Prototype-Fund-Hardware/MYND-Hardware/README.md

# MYND loudspeaker 
This is a community repository (inofficial) for the open hardware of the Teufel loudspeaker MYND: https://teufel.de/mynd-107002004

Due to the file size, the STL files were not uploaded. They can be downloaded directly from the Teufel website: https://docs.teufel.de/download/MYND/open_source.zip

The repository for the firmware can be found here: https://github.com/teufelaudio/mynd-firmware

## License 
CC BY-SA 4.0 Copyright (c) 2025 Lautsprecher Teufel GmbH. 
The corresponding licenses can be found in the CAD and PCB folders.
