Prototype-Fund-Hardware/MYND-Hardware/PCB_Schematic/KiCad/Conn_Amp/ALTIUM_EMBEDDED_MODELS/tsb0-0128d-00xxa_asm__sw0001.stp

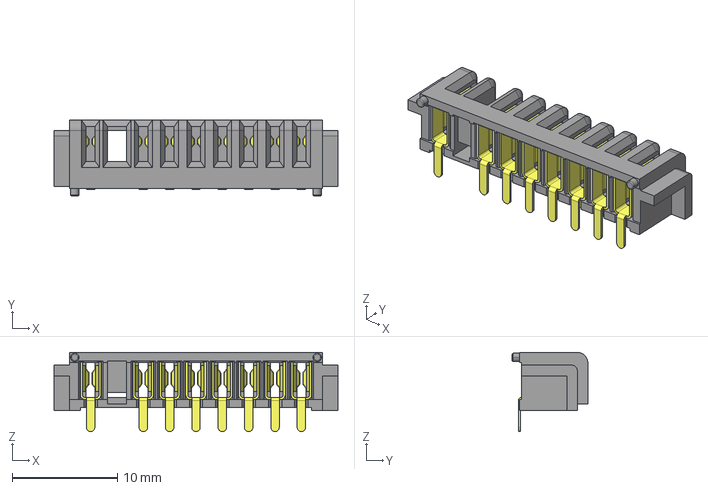
[picture p1: CAD file, 2025-05-21]
PCB_Schematic/KiCad/Conn_Amp/ALTIUM_EMBEDDED_MODELS/tsb0-0128d-00xxa_asm__sw0001.stp
26.9 x 7.18 x 7.52 mm
