Prototype-Fund-Hardware/MYND-Hardware/PCB_Schematic/KiCad/Jack_Line_In/ALTIUM_EMBEDDED_MODELS/phb-row-st-smt-2-3p_asm.stp

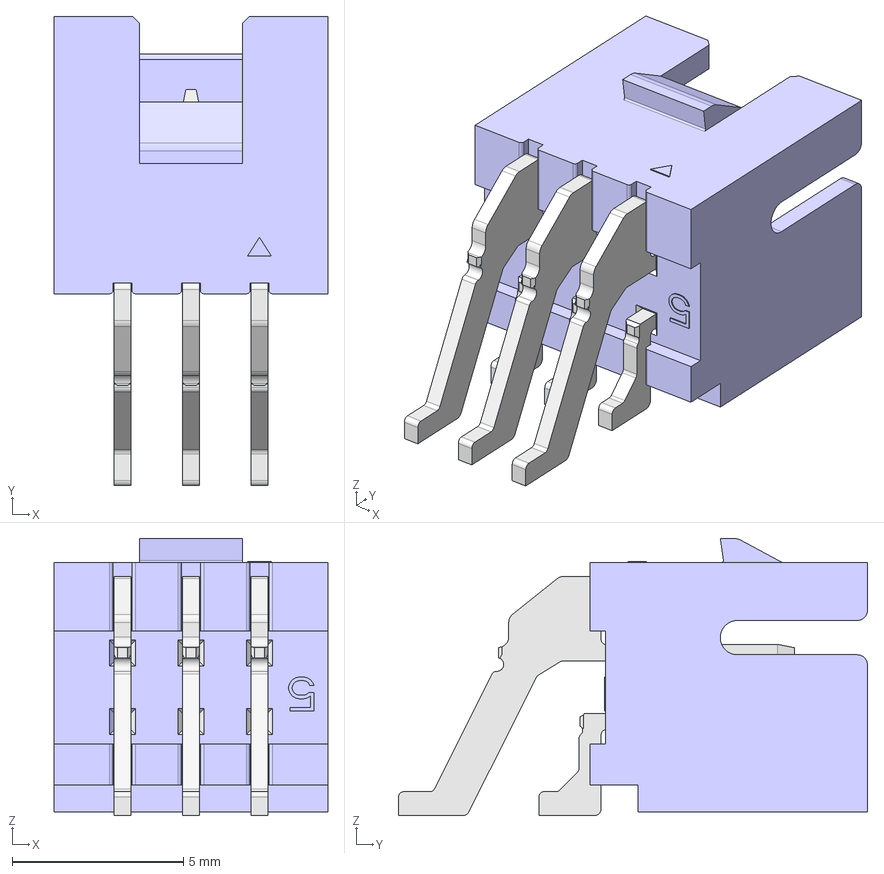
[picture p2: CAD file, 2025-05-21]
PCB_Schematic/KiCad/Jack_Line_In/ALTIUM_EMBEDDED_MODELS/phb-row-st-smt-2-3p_asm.stp
8.00 x 13.7 x 8.10 mm
