Prototype-Fund-Hardware/MYND-Hardware/PCB_Schematic/KiCad/Jack_USB/ALTIUM_EMBEDDED_MODELS/PHB-ROW-ST-SMT-2-5P_ASM.step

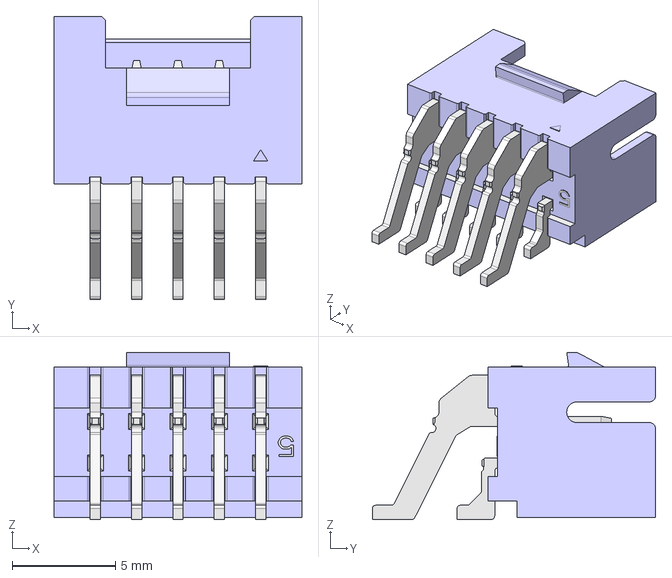
[picture p3: CAD file, 2025-05-21]
PCB_Schematic/KiCad/Jack_USB/ALTIUM_EMBEDDED_MODELS/PHB-ROW-ST-SMT-2-5P_ASM.step
12.0 x 13.7 x 8.10 mm
