Prototype-Fund-Hardware/MYND-Hardware/CAD/STP/MYND Print parts Rubber inserts.stp

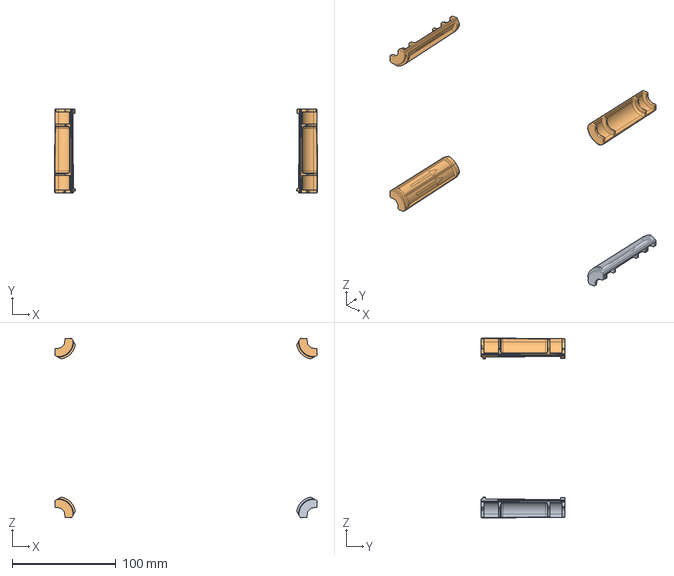
[picture p4: CAD file, 2025-05-21]
CAD/STP/MYND Print parts Rubber inserts.stp
253.1 x 81.0 x 173.1 mm
