Prototype-Fund-Hardware/MYND-Hardware/PCB_Schematic/Altium/Main/ALTIUM_EMBEDDED_MODELS/pin_header_a-sl254-eg-g03mr1.stp

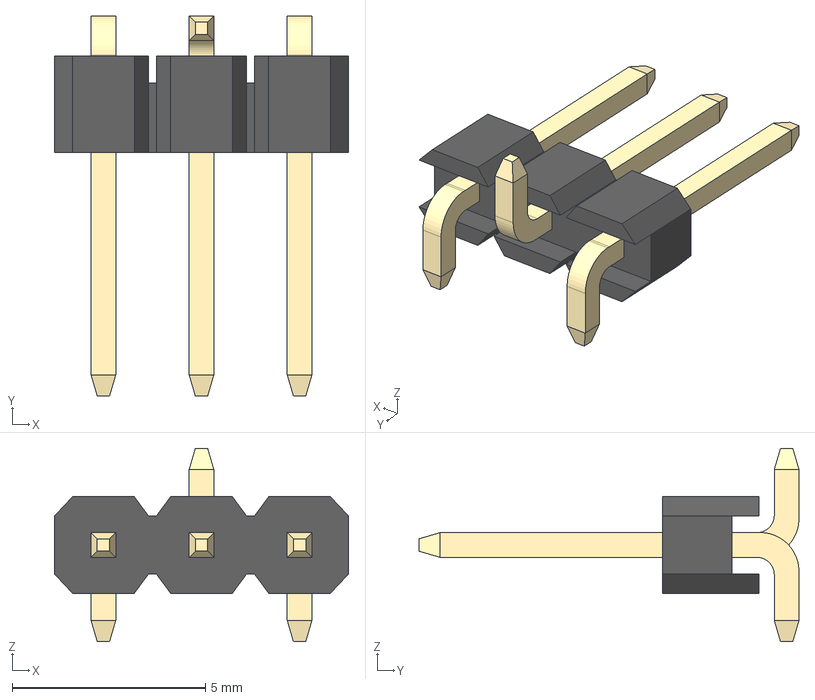
[picture p5: CAD file, 2025-05-21]
PCB_Schematic/Altium/Main/ALTIUM_EMBEDDED_MODELS/pin_header_a-sl254-eg-g03mr1.stp
7.62 x 9.84 x 5.00 mm
