Prototype-Fund-Hardware/MYND-Hardware/PCB_Schematic/KiCad/Amp/ALTIUM_EMBEDDED_MODELS/10x10_Chip.stp

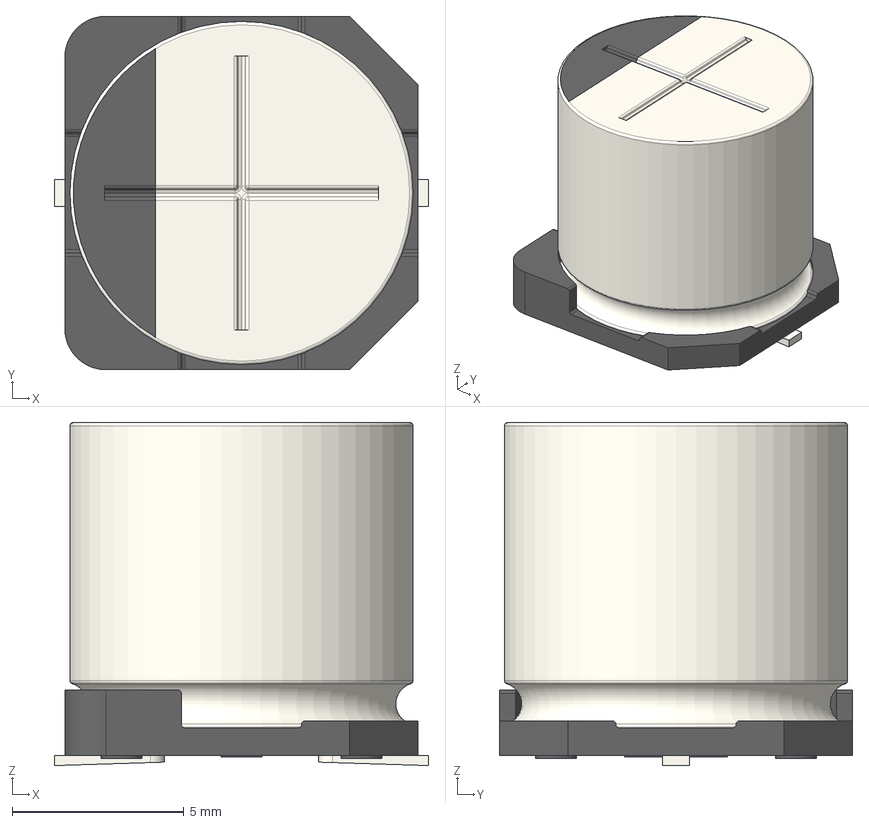
[picture p6: CAD file, 2025-05-21]
PCB_Schematic/KiCad/Amp/ALTIUM_EMBEDDED_MODELS/10x10_Chip.stp
10.9 x 10.3 x 10.0 mm
