Prototype-Fund-Hardware/MYND-Hardware/PCB_Schematic/KiCad/Bluetooth/ALTIUM_EMBEDDED_MODELS/User Library-SOT-23-2.STEP

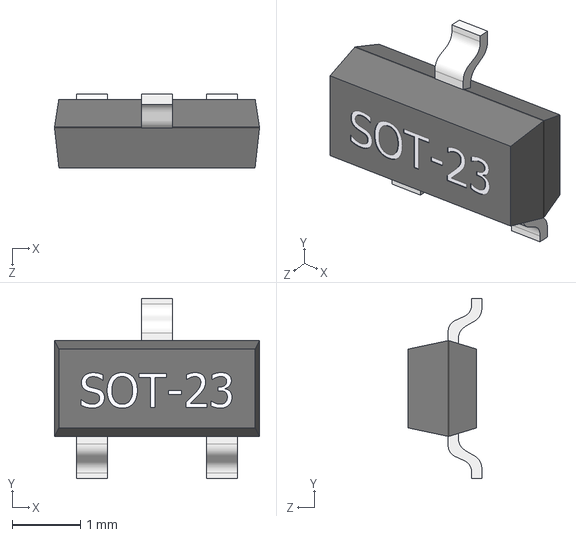
[picture p7: CAD file, 2025-05-21]
PCB_Schematic/KiCad/Bluetooth/ALTIUM_EMBEDDED_MODELS/User Library-SOT-23-2.STEP
3.00 x 2.64 x 1.08 mm
