Prototype-Fund-Hardware/MYND-Hardware/PCB_Schematic/KiCad/Conn_Baffle/ALTIUM_EMBEDDED_MODELS/A2501_6P.step

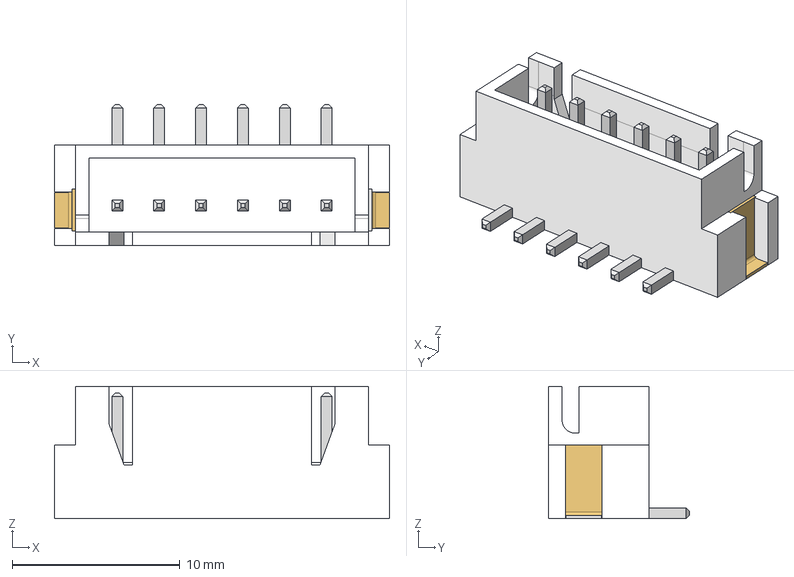
[picture p8: CAD file, 2025-05-21]
PCB_Schematic/KiCad/Conn_Baffle/ALTIUM_EMBEDDED_MODELS/A2501_6P.step
20.0 x 8.40 x 7.90 mm
Pin004
Pin005
Pin006
Pin007
Pin008
Pin009
FPin001
FPin002
FPin002_(Mirror_#1)
