Prototype-Fund-Hardware/MYND-Hardware/PCB_Schematic/KiCad/Conn_Bat/ALTIUM_EMBEDDED_MODELS/A2501W_8P.step

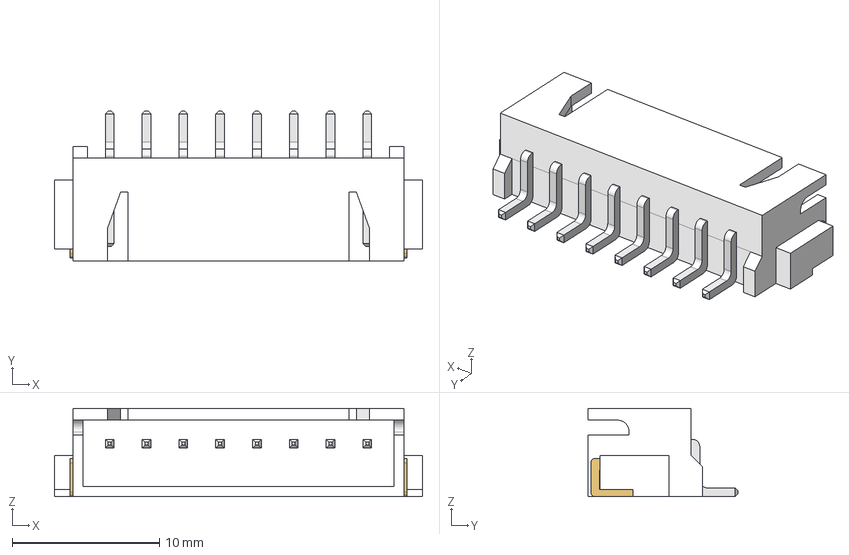
[picture p9: CAD file, 2025-05-21]
PCB_Schematic/KiCad/Conn_Bat/ALTIUM_EMBEDDED_MODELS/A2501W_8P.step
25.0 x 10.2 x 6.00 mm
FPin001
FPin002
FPin002_(Mirror_#1)
PIN001
PIN002
PIN003
PIN004
PIN005
PIN006
PIN007
PIN008
