Prototype-Fund-Hardware/MYND-Hardware/PCB_Schematic/KiCad/Jack_USB/ALTIUM_EMBEDDED_MODELS/User Library-RESC1005X___.step

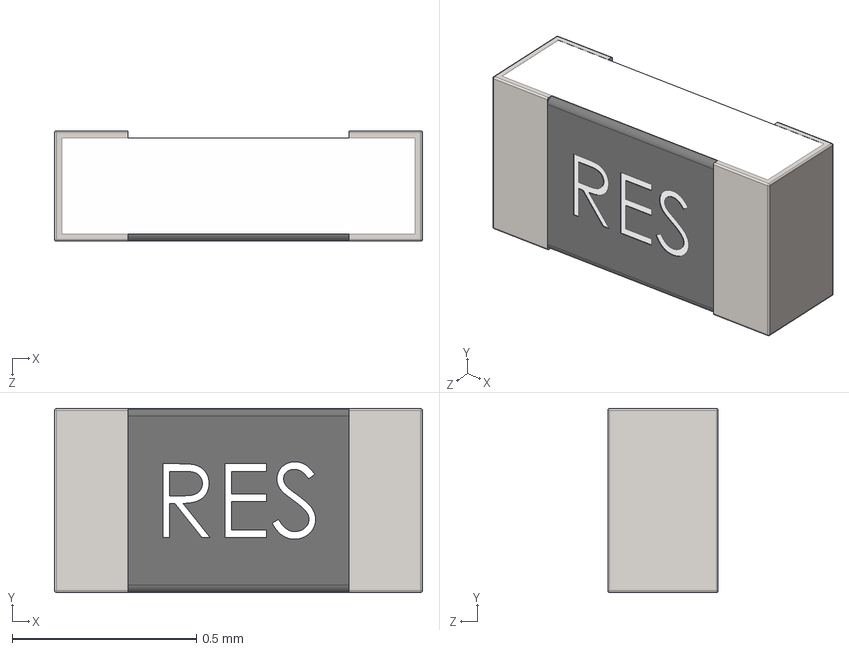
[picture p10: CAD file, 2025-05-21]
PCB_Schematic/KiCad/Jack_USB/ALTIUM_EMBEDDED_MODELS/User Library-RESC1005X___.step
1.00 x 0.5 x 0.3 mm
