Prototype-Fund-Hardware/MYND-Hardware/PCB_Schematic/KiCad/Main/ALTIUM_EMBEDDED_MODELS/0603_105.step

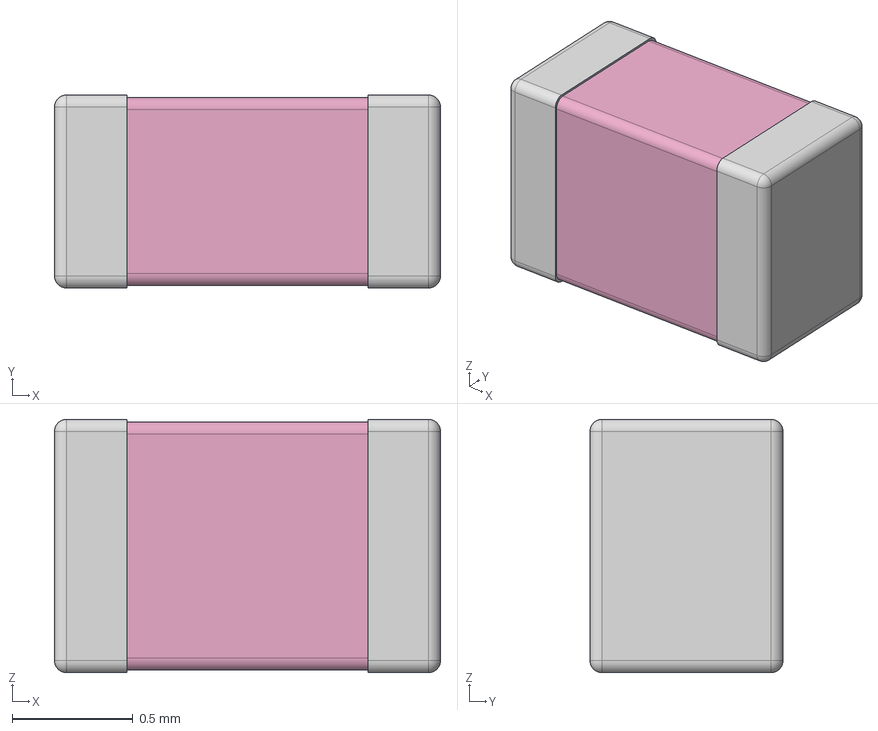
[picture p11: CAD file, 2025-05-21]
PCB_Schematic/KiCad/Main/ALTIUM_EMBEDDED_MODELS/0603_105.step
1.60 x 0.8 x 1.05 mm
