Prototype-Fund-Hardware/MYND-Hardware/PCB_Schematic/KiCad/UI/ALTIUM_EMBEDDED_MODELS/User Library-CAPC3216X___.step

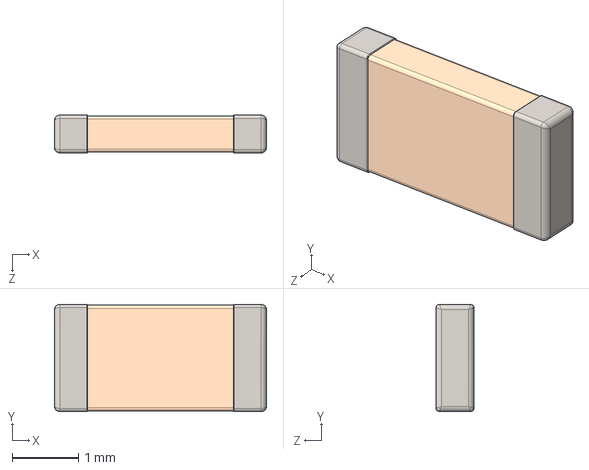
[picture p12: CAD file, 2025-05-21]
PCB_Schematic/KiCad/UI/ALTIUM_EMBEDDED_MODELS/User Library-CAPC3216X___.step
3.20 x 1.62 x 0.57 mm
