Prototype-Fund-Hardware/MYND-Hardware/CAD/STP/MYND Print parts Port housing.stp

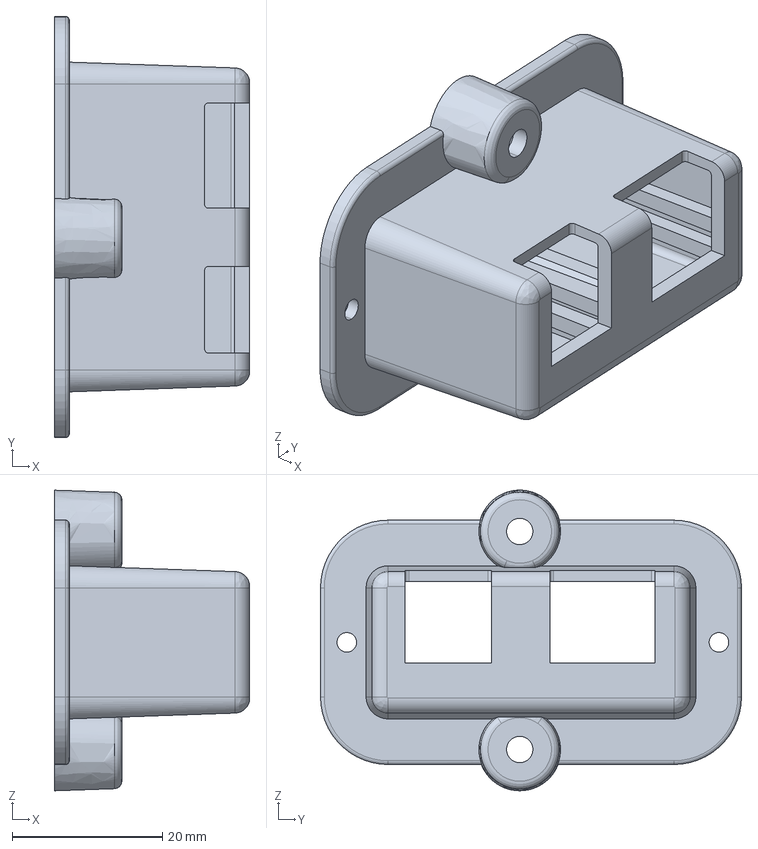
[picture p13: CAD file, 2025-05-21]
CAD/STP/MYND Print parts Port housing.stp
26.0 x 56.0 x 40.0 mm
