Prototype-Fund-Hardware/MYND-Hardware/PCB_Schematic/KiCad/Amp/ALTIUM_EMBEDDED_MODELS/0805_125.step

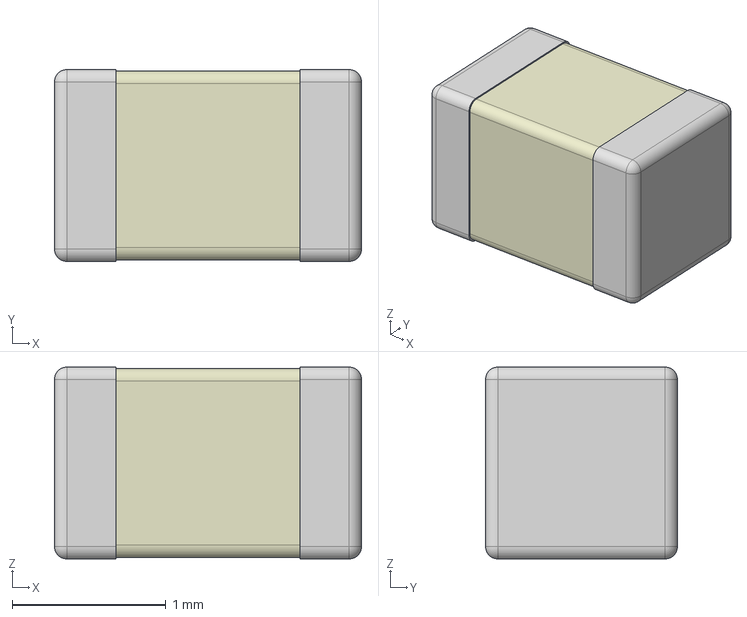
[picture p14: CAD file, 2025-05-21]
PCB_Schematic/KiCad/Amp/ALTIUM_EMBEDDED_MODELS/0805_125.step
2.00 x 1.25 x 1.25 mm
