Prototype-Fund-Hardware/MYND-Hardware/PCB_Schematic/KiCad/Bluetooth/ALTIUM_EMBEDDED_MODELS/D0008A.stp

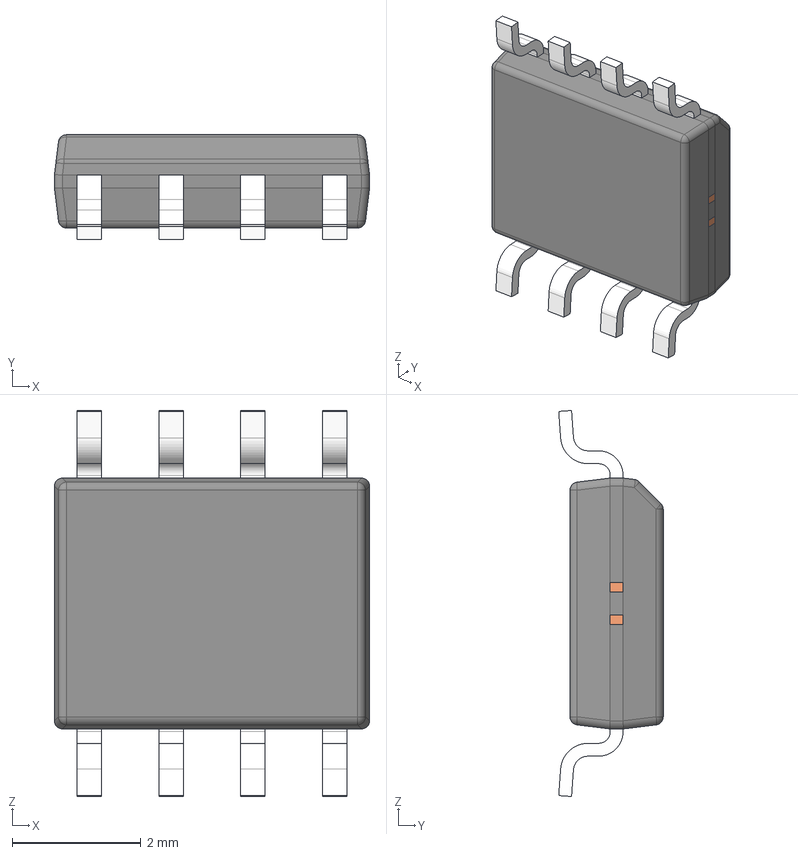
[picture p15: CAD file, 2025-05-21]
PCB_Schematic/KiCad/Bluetooth/ALTIUM_EMBEDDED_MODELS/D0008A.stp
4.90 x 1.62 x 6.00 mm
BODY_M08A_35
LEAD_M08A_57 x 8
MANIFOLD_SOLID_BREP_2784
MANIFOLD_SOLID_BREP_2935
MANIFOLD_SOLID_BREP_3086
MANIFOLD_SOLID_BREP_3237
