Prototype-Fund-Hardware/MYND-Hardware/PCB_Schematic/KiCad/Conn_Amp/ALTIUM_EMBEDDED_MODELS/pin_header_a-sl254-da-g10mp1.stp

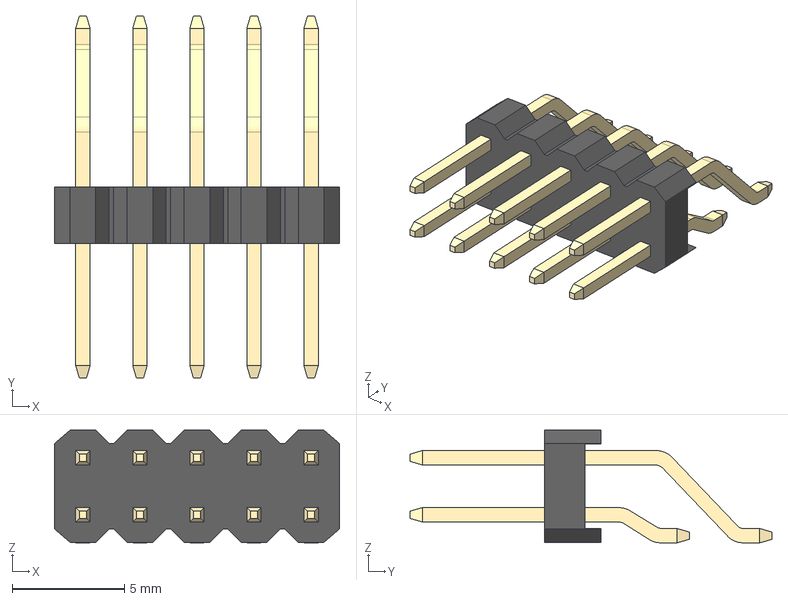
[picture p16: CAD file, 2025-05-21]
PCB_Schematic/KiCad/Conn_Amp/ALTIUM_EMBEDDED_MODELS/pin_header_a-sl254-da-g10mp1.stp
12.7 x 16.1 x 5.02 mm
