Prototype-Fund-Hardware/MYND-Hardware/PCB_Schematic/KiCad/Jack_USB/ALTIUM_EMBEDDED_MODELS/0603_50.step

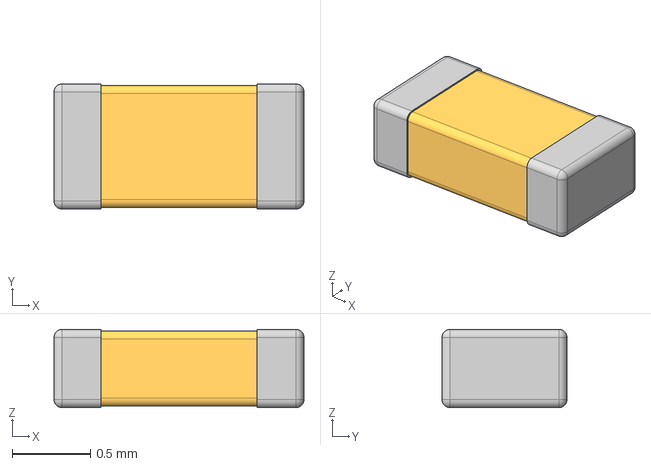
[picture p17: CAD file, 2025-05-21]
PCB_Schematic/KiCad/Jack_USB/ALTIUM_EMBEDDED_MODELS/0603_50.step
1.60 x 0.8 x 0.5 mm
