Prototype-Fund-Hardware/MYND-Hardware/PCB_Schematic/KiCad/Main/ALTIUM_EMBEDDED_MODELS/0603_80.step

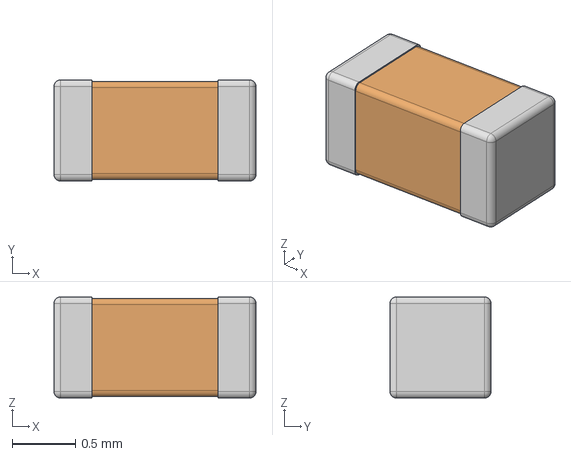
[picture p18: CAD file, 2025-05-21]
PCB_Schematic/KiCad/Main/ALTIUM_EMBEDDED_MODELS/0603_80.step
1.60 x 0.8 x 0.8 mm
