Prototype-Fund-Hardware/MYND-Hardware/CAD/STP/MYND Print parts Rubber sealing.stp

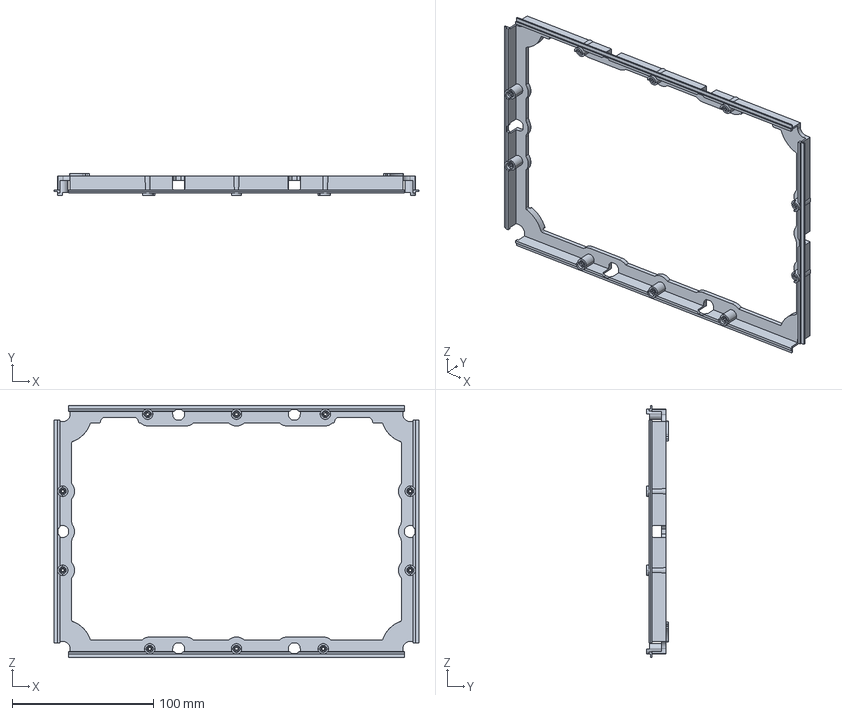
[picture p19: CAD file, 2025-05-21]
CAD/STP/MYND Print parts Rubber sealing.stp
258.8 x 15.4 x 178.8 mm
