Prototype-Fund-Hardware/MYND-Hardware/PCB_Schematic/Altium/Main/ALTIUM_EMBEDDED_MODELS/pin_header_a-sl127-dg-g10mp1.stp

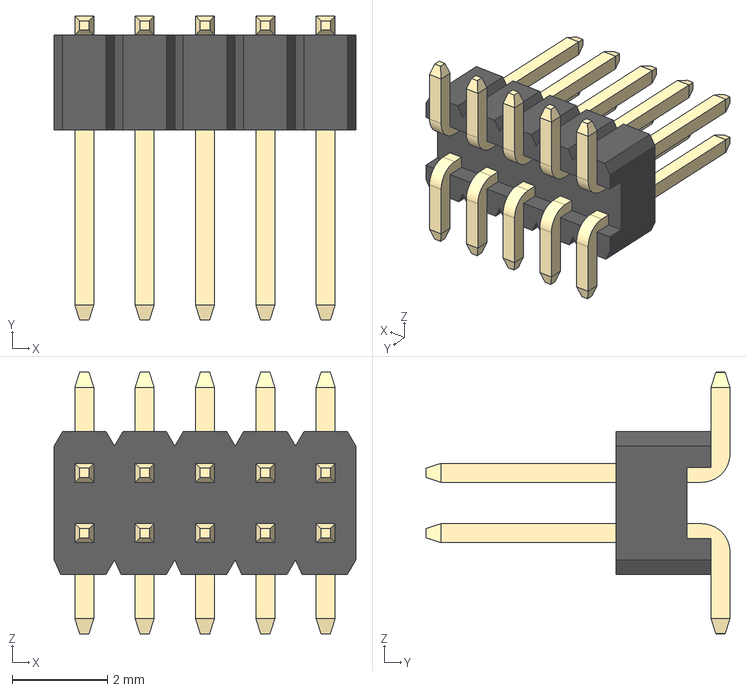
[picture p20: CAD file, 2025-05-21]
PCB_Schematic/Altium/Main/ALTIUM_EMBEDDED_MODELS/pin_header_a-sl127-dg-g10mp1.stp
6.35 x 6.40 x 5.50 mm
