Prototype-Fund-Hardware/MYND-Hardware/PCB_Schematic/KiCad/Amp/ALTIUM_EMBEDDED_MODELS/8x10_Chip.stp

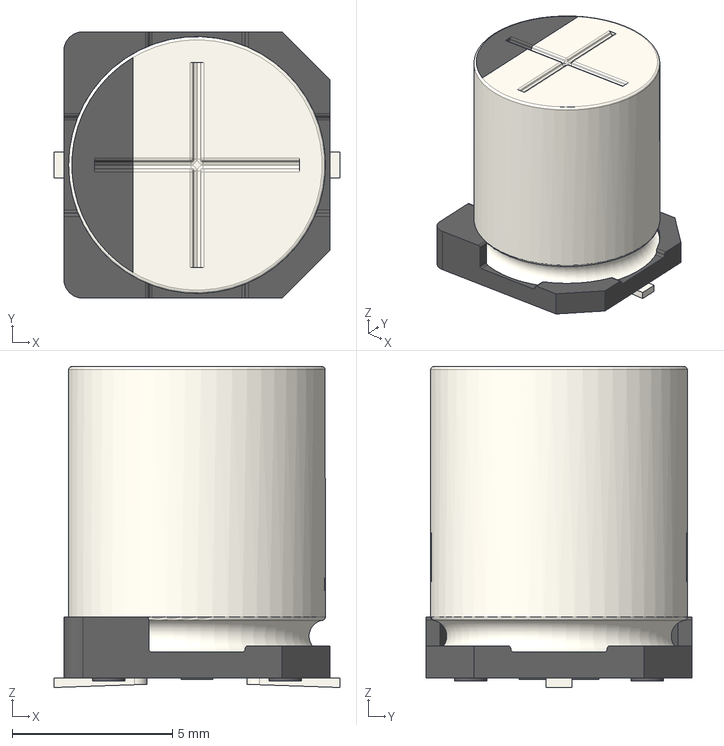
[picture p21: CAD file, 2025-05-21]
PCB_Schematic/KiCad/Amp/ALTIUM_EMBEDDED_MODELS/8x10_Chip.stp
8.90 x 8.30 x 10.0 mm
