Prototype-Fund-Hardware/MYND-Hardware/PCB_Schematic/KiCad/Bluetooth/ALTIUM_EMBEDDED_MODELS/0805_145.step

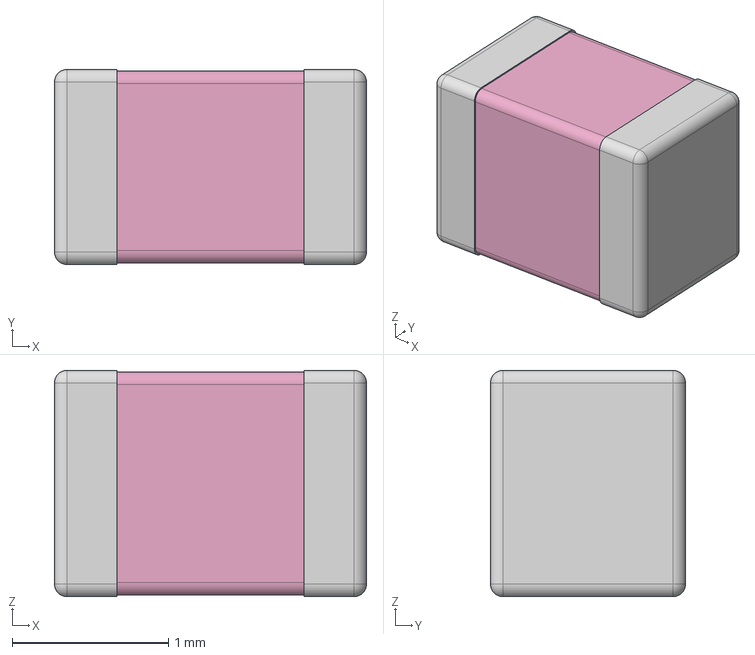
[picture p22: CAD file, 2025-05-21]
PCB_Schematic/KiCad/Bluetooth/ALTIUM_EMBEDDED_MODELS/0805_145.step
2.00 x 1.25 x 1.45 mm
