Prototype-Fund-Hardware/MYND-Hardware/PCB_Schematic/KiCad/Jack_Line_In/ALTIUM_EMBEDDED_MODELS/User Library-INDC1608X___.step

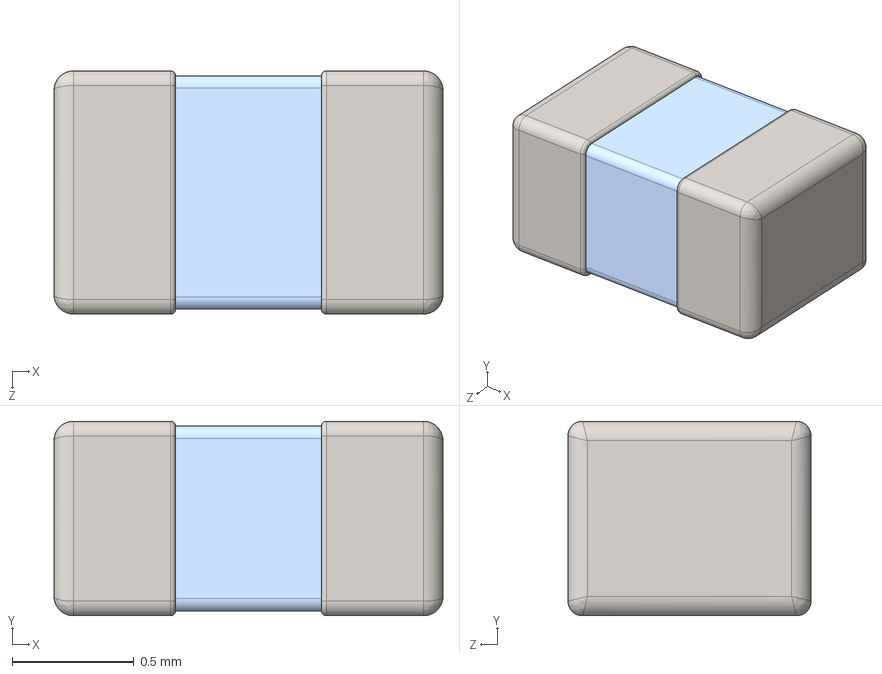
[picture p23: CAD file, 2025-05-21]
PCB_Schematic/KiCad/Jack_Line_In/ALTIUM_EMBEDDED_MODELS/User Library-INDC1608X___.step
1.60 x 0.8 x 1.00 mm
