Prototype-Fund-Hardware/MYND-Hardware/CAD/STP/MYND Print parts PR Frame.stp

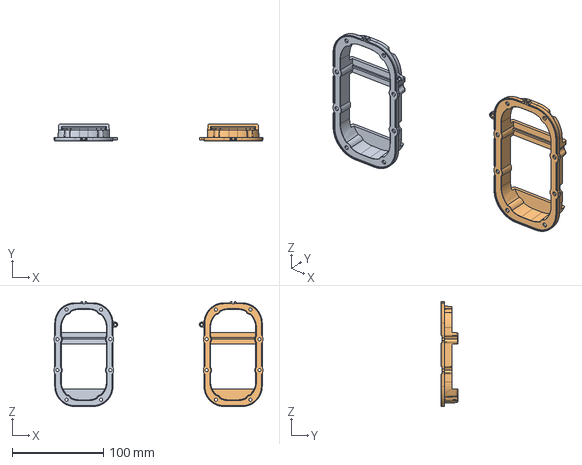
[picture p24: CAD file, 2025-05-21]
CAD/STP/MYND Print parts PR Frame.stp
229.6 x 19.0 x 115.5 mm
