Prototype-Fund-Hardware/MYND-Hardware/PCB_Schematic/KiCad/Amp/ALTIUM_EMBEDDED_MODELS/JSHC0650.step

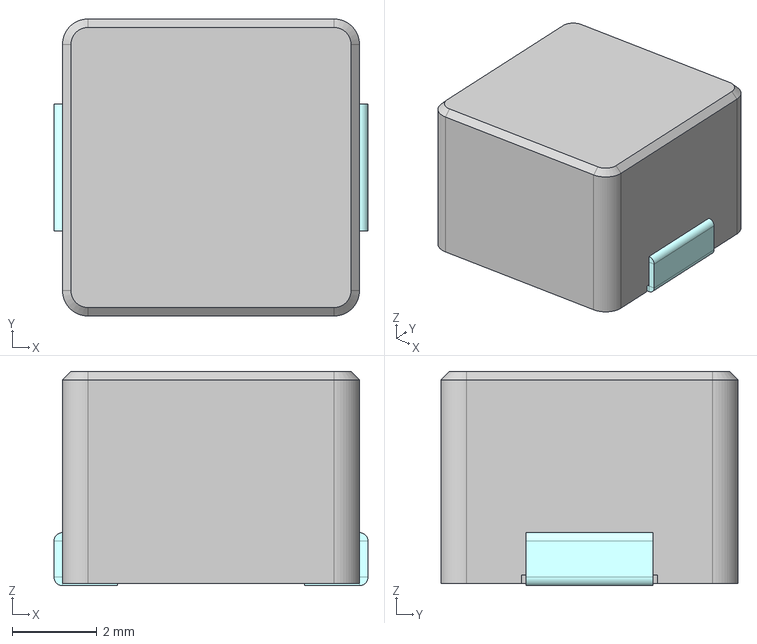
[picture p25: CAD file, 2025-05-21]
PCB_Schematic/KiCad/Amp/ALTIUM_EMBEDDED_MODELS/JSHC0650.step
7.40 x 7.00 x 5.05 mm
PIN
