Prototype-Fund-Hardware/MYND-Hardware/PCB_Schematic/KiCad/Bluetooth/ALTIUM_EMBEDDED_MODELS/User Library-IPEX.STEP

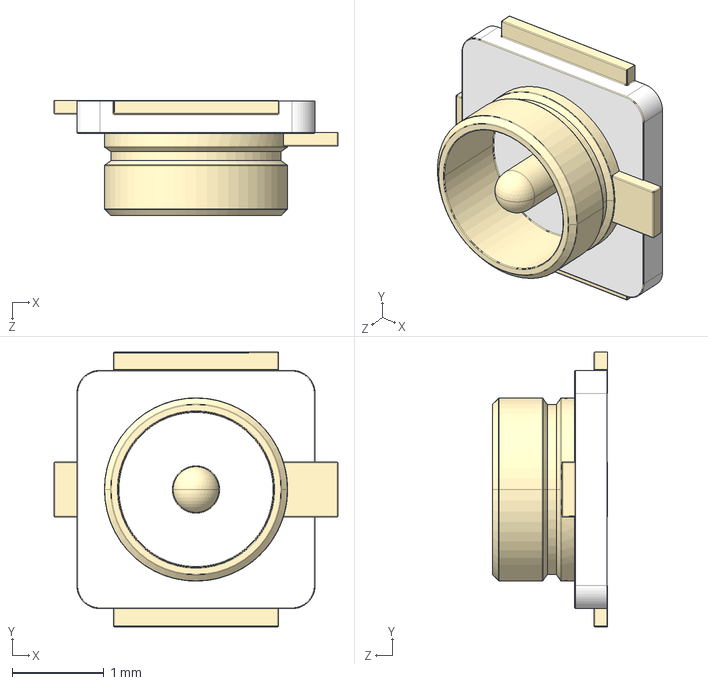
[picture p26: CAD file, 2025-05-21]
PCB_Schematic/KiCad/Bluetooth/ALTIUM_EMBEDDED_MODELS/User Library-IPEX.STEP
3.10 x 3.00 x 1.26 mm
