Prototype-Fund-Hardware/MYND-Hardware/PCB_Schematic/KiCad/Jack_USB/ALTIUM_EMBEDDED_MODELS/DFN70P101X50-2N.step

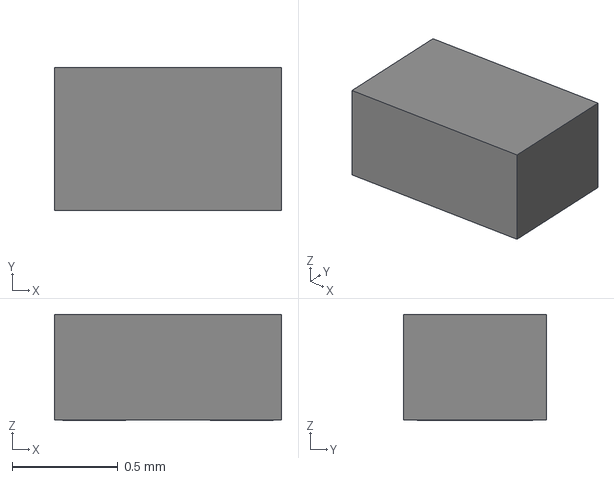
[picture p27: CAD file, 2025-05-21]
PCB_Schematic/KiCad/Jack_USB/ALTIUM_EMBEDDED_MODELS/DFN70P101X50-2N.step
1.07 x 0.675 x 0.503 mm
bigPin x 2
