Prototype-Fund-Hardware/MYND-Hardware/PCB_Schematic/KiCad/Main/ALTIUM_EMBEDDED_MODELS/TMPA1206.step

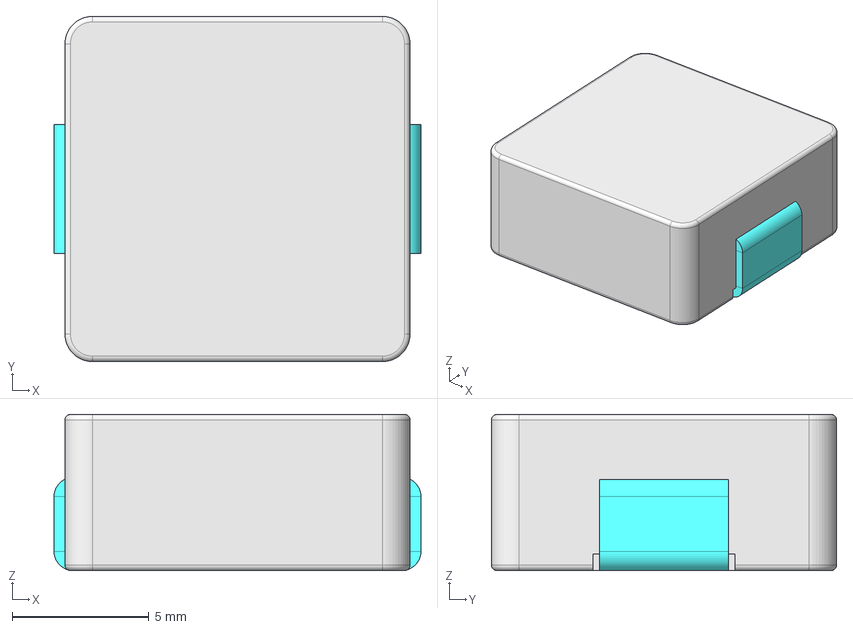
[picture p28: CAD file, 2025-05-21]
PCB_Schematic/KiCad/Main/ALTIUM_EMBEDDED_MODELS/TMPA1206.step
13.4 x 12.6 x 5.70 mm
Pin
