Prototype-Fund-Hardware/MYND-Hardware/CAD/STP/MYND Print parts Rubber feet.stp

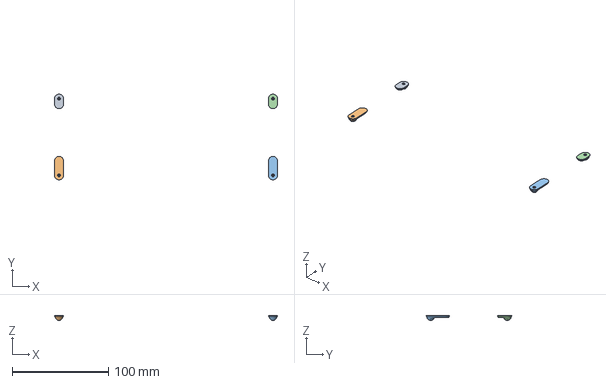
[picture p29: CAD file, 2025-05-21]
CAD/STP/MYND Print parts Rubber feet.stp
232.1 x 89.2 x 5.49 mm
