Prototype-Fund-Hardware/MYND-Hardware/PCB_Schematic/KiCad/Bluetooth/ALTIUM_EMBEDDED_MODELS/ICMF062P.step

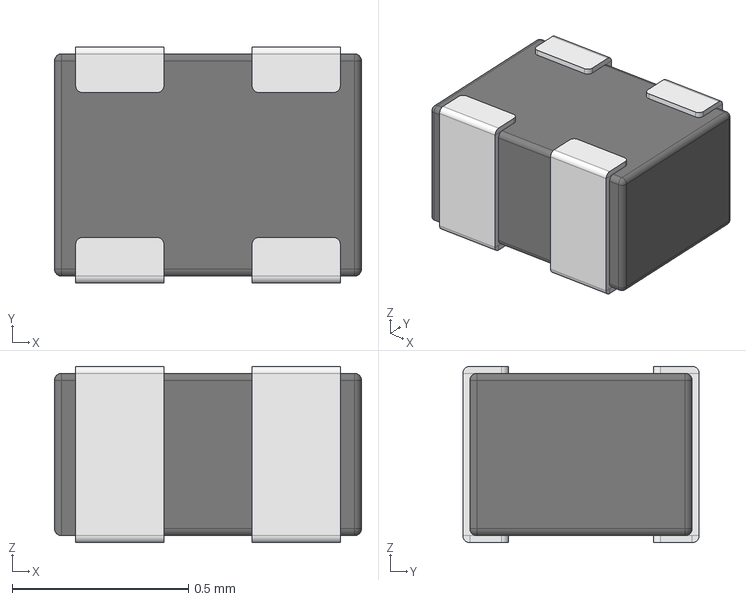
[picture p30: CAD file, 2025-05-21]
PCB_Schematic/KiCad/Bluetooth/ALTIUM_EMBEDDED_MODELS/ICMF062P.step
0.87 x 0.67 x 0.5 mm
