Prototype-Fund-Hardware/MYND-Hardware/PCB_Schematic/KiCad/Jack_Line_In/ALTIUM_EMBEDDED_MODELS/User Library-RESC1608X___.STEP

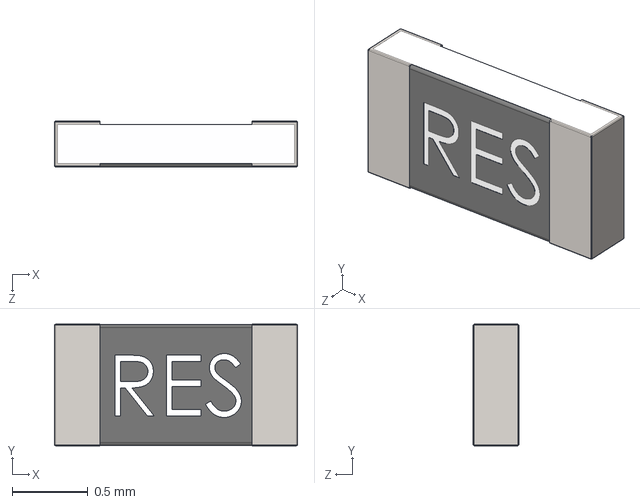
[picture p31: CAD file, 2025-05-21]
PCB_Schematic/KiCad/Jack_Line_In/ALTIUM_EMBEDDED_MODELS/User Library-RESC1608X___.STEP
1.60 x 0.8 x 0.3 mm
