Prototype-Fund-Hardware/MYND-Hardware/PCB_Schematic/KiCad/Jack_USB/ALTIUM_EMBEDDED_MODELS/User Library-SOD-123FL CASE 498.STEP

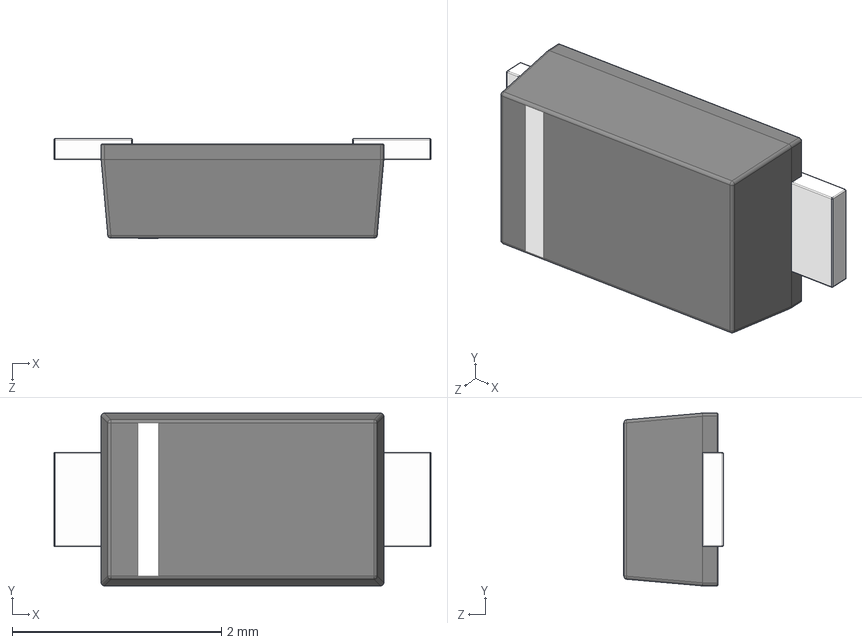
[picture p32: CAD file, 2025-05-21]
PCB_Schematic/KiCad/Jack_USB/ALTIUM_EMBEDDED_MODELS/User Library-SOD-123FL CASE 498.STEP
3.60 x 1.65 x 0.951 mm
