Prototype-Fund-Hardware/MYND-Hardware/CAD/STP/MYND Print parts Rubber HMI pad.stp

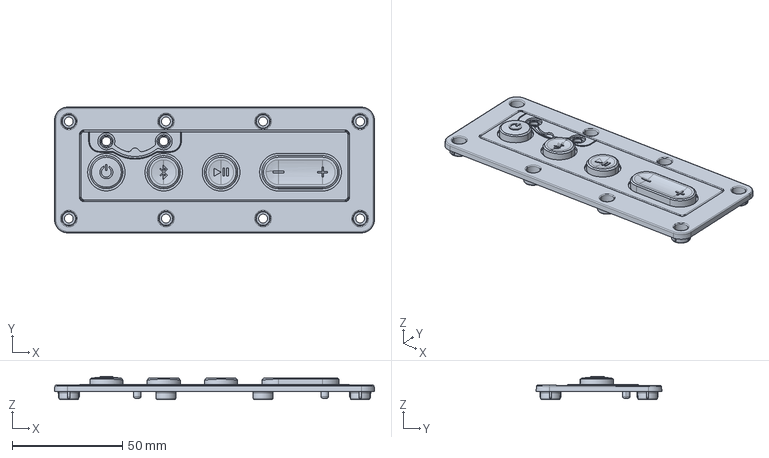
[picture p34: CAD file, 2025-05-21]
CAD/STP/MYND Print parts Rubber HMI pad.stp
145.0 x 57.0 x 10.5 mm
