Prototype-Fund-Hardware/MYND-Hardware/CAD/STP/MYND Print parts HMI cover.stp

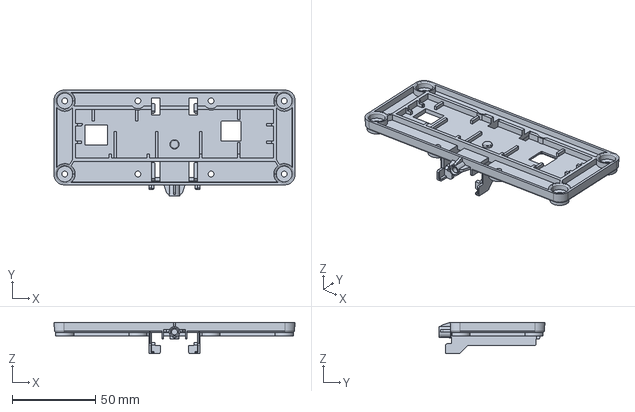
[picture p35: CAD file, 2025-05-21]
CAD/STP/MYND Print parts HMI cover.stp
145.0 x 63.7 x 18.9 mm
