Prototype-Fund-Hardware/MYND-Hardware/PCB_Schematic/KiCad/Jack_USB/ALTIUM_EMBEDDED_MODELS/K3D-DX07WH24JA3-V2_JAE_Proprietary.STEP

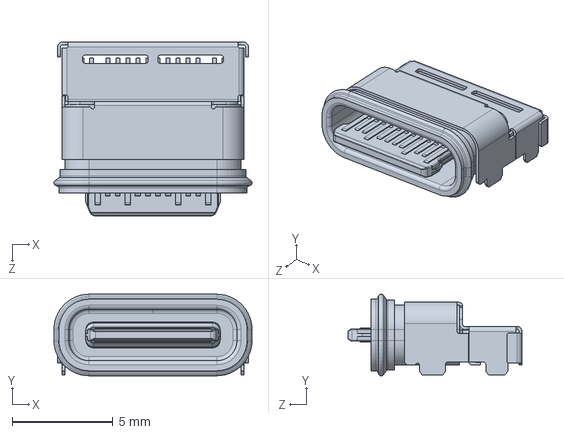
[picture p37: CAD file, 2025-05-21]
PCB_Schematic/KiCad/Jack_USB/ALTIUM_EMBEDDED_MODELS/K3D-DX07WH24JA3-V2_JAE_Proprietary.STEP
9.85 x 4.06 x 8.65 mm
