Prototype-Fund-Hardware/MYND-Hardware/PCB_Schematic/KiCad/Main/ALTIUM_EMBEDDED_MODELS/DBV0003A.stp

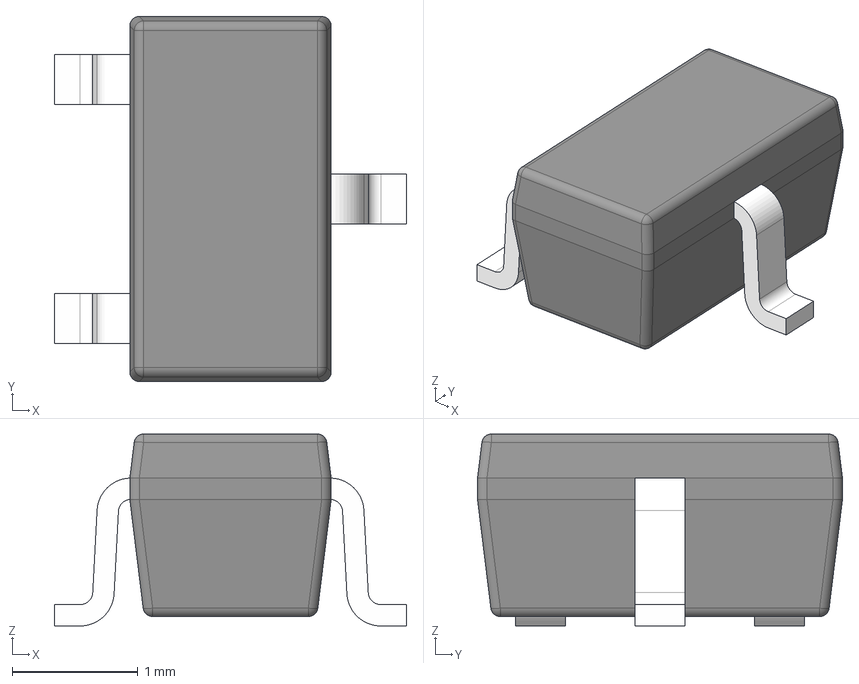
[picture p38: CAD file, 2025-05-21]
PCB_Schematic/KiCad/Main/ALTIUM_EMBEDDED_MODELS/DBV0003A.stp
2.80 x 2.90 x 1.52 mm
LEAD x 3
