Prototype-Fund-Hardware/MYND-Hardware/PCB_Schematic/Altium/Main/ALTIUM_EMBEDDED_MODELS/User Library-SOT457.STEP

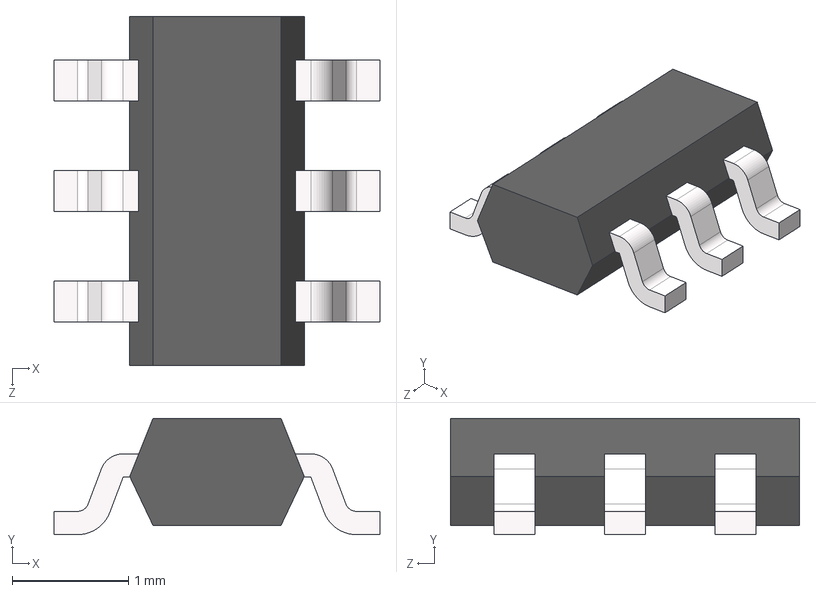
[picture p39: CAD file, 2025-05-21]
PCB_Schematic/Altium/Main/ALTIUM_EMBEDDED_MODELS/User Library-SOT457.STEP
2.80 x 1.00 x 3.00 mm
User Library-SOT457_body
User Library-SOT457_pin x 6
