Prototype-Fund-Hardware/MYND-Hardware/PCB_Schematic/KiCad/Main/ALTIUM_EMBEDDED_MODELS/phb-row-st-smt-2-3p.stp

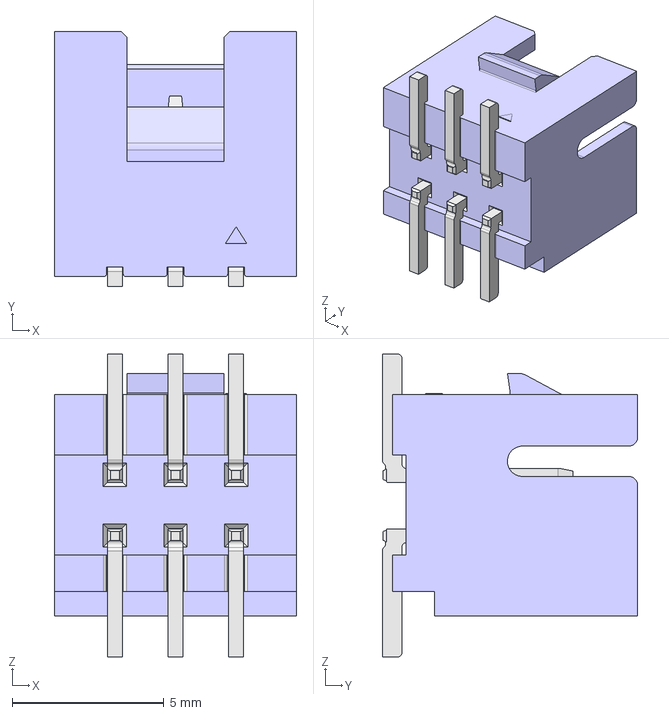
[picture p40: CAD file, 2025-05-21]
PCB_Schematic/KiCad/Main/ALTIUM_EMBEDDED_MODELS/phb-row-st-smt-2-3p.stp
8.00 x 8.43 x 10.0 mm
