Prototype-Fund-Hardware/MYND-Hardware/PCB_Schematic/Altium/Main/ALTIUM_EMBEDDED_MODELS/User Library-SOT-23-5.STEP

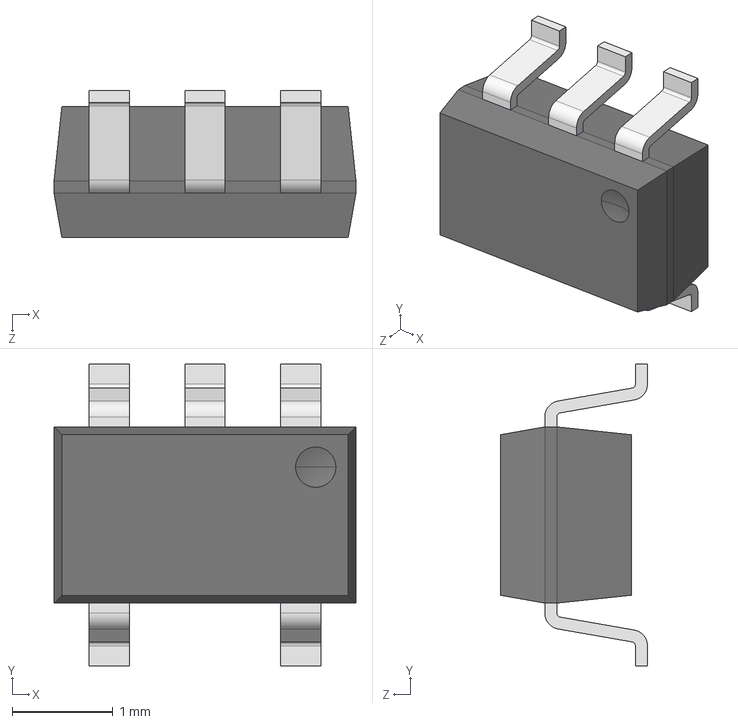
[picture p41: CAD file, 2025-05-21]
PCB_Schematic/Altium/Main/ALTIUM_EMBEDDED_MODELS/User Library-SOT-23-5.STEP
3.00 x 3.00 x 1.46 mm
User Library-SOT-23-5_pin_SOT_sot-23-6_1 x 5
User Library-SOT-23-5_body_sot23-6_1
