Prototype-Fund-Hardware/MYND-Hardware/PCB_Schematic/KiCad/Bluetooth/ALTIUM_EMBEDDED_MODELS/User Library-SOD2513X11.STEP

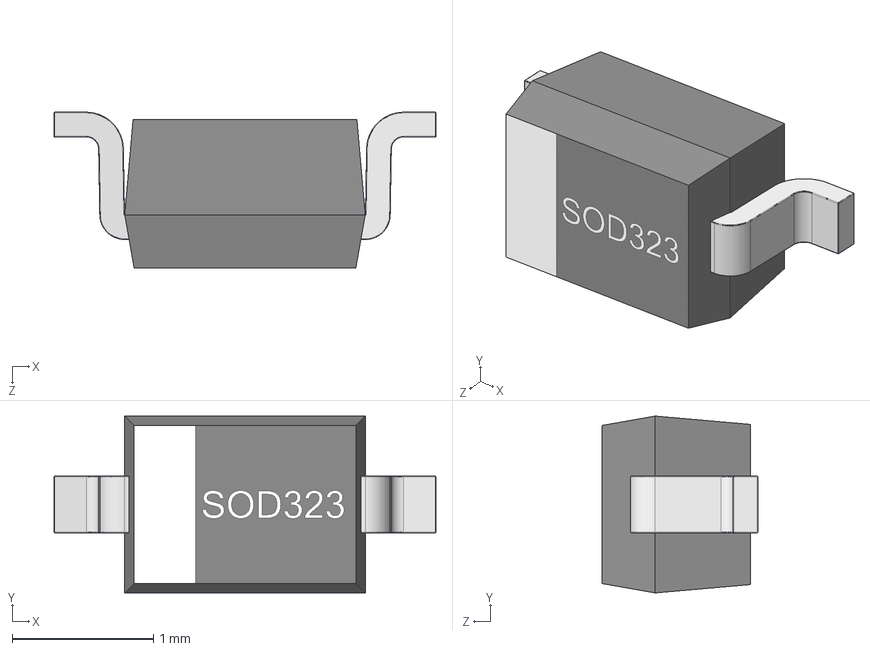
[picture p42: CAD file, 2025-05-21]
PCB_Schematic/KiCad/Bluetooth/ALTIUM_EMBEDDED_MODELS/User Library-SOD2513X11.STEP
2.70 x 1.25 x 1.10 mm
