Prototype-Fund-Hardware/MYND-Hardware/PCB_Schematic/Altium/Main/ALTIUM_EMBEDDED_MODELS/RSW0010A.stp

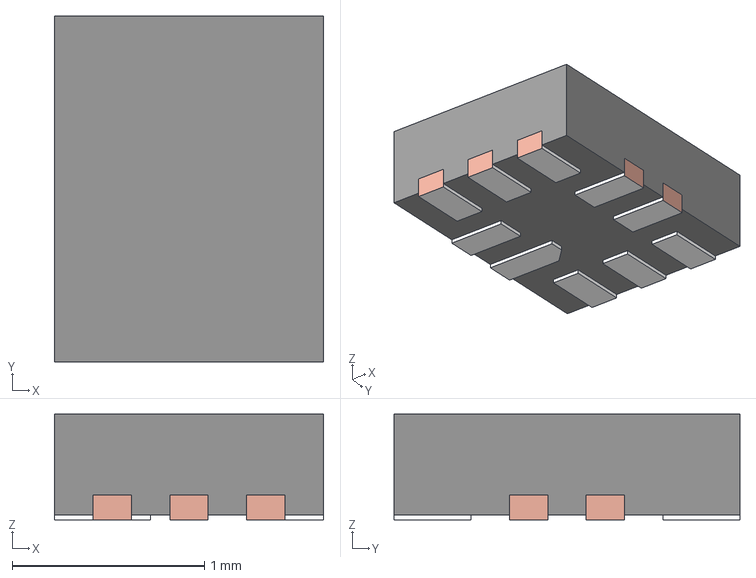
[picture p44: CAD file, 2025-05-21]
PCB_Schematic/Altium/Main/ALTIUM_EMBEDDED_MODELS/RSW0010A.stp
1.40 x 1.80 x 0.55 mm
FRAME
