Prototype-Fund-Hardware/MYND-Hardware/PCB_Schematic/KiCad/UI/ALTIUM_EMBEDDED_MODELS/WB200AL-12.stp

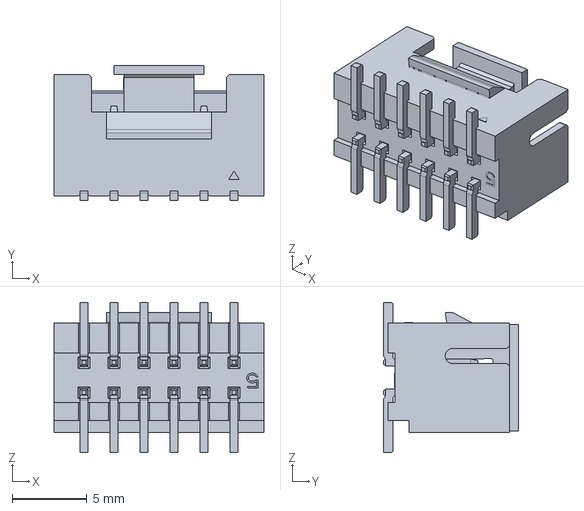
[picture p46: CAD file, 2025-05-21]
PCB_Schematic/KiCad/UI/ALTIUM_EMBEDDED_MODELS/WB200AL-12.stp
14.0 x 9.03 x 10.0 mm
