Prototype-Fund-Hardware/MYND-Hardware/PCB_Schematic/Altium/Main/ALTIUM_EMBEDDED_MODELS/User Library-CAPC1005X___.step

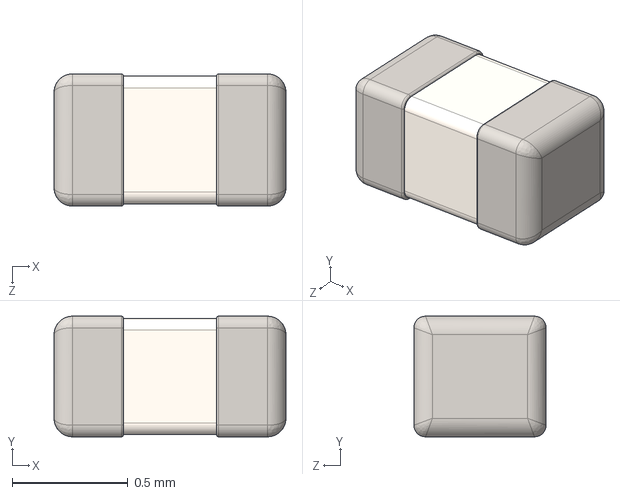
[picture p47: CAD file, 2025-05-21]
PCB_Schematic/Altium/Main/ALTIUM_EMBEDDED_MODELS/User Library-CAPC1005X___.step
1.00 x 0.52 x 0.57 mm
