Prototype-Fund-Hardware/MYND-Hardware/PCB_Schematic/KiCad/Amp/ALTIUM_EMBEDDED_MODELS/User Library-RESC3216X___.step

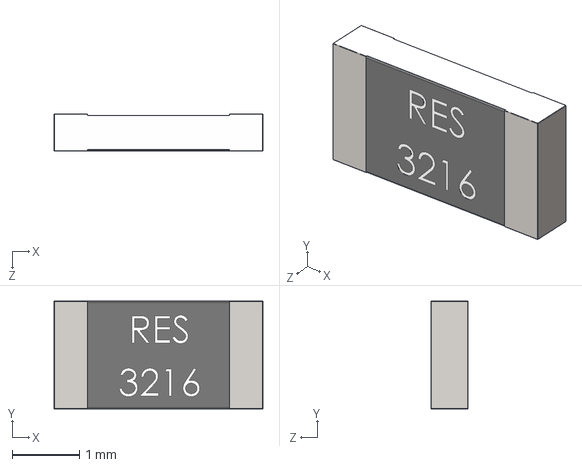
[picture p48: CAD file, 2025-05-21]
PCB_Schematic/KiCad/Amp/ALTIUM_EMBEDDED_MODELS/User Library-RESC3216X___.step
3.10 x 1.60 x 0.55 mm
