Prototype-Fund-Hardware/MYND-Hardware/PCB_Schematic/KiCad/Bluetooth/ALTIUM_EMBEDDED_MODELS/SOP127P600-8N.step

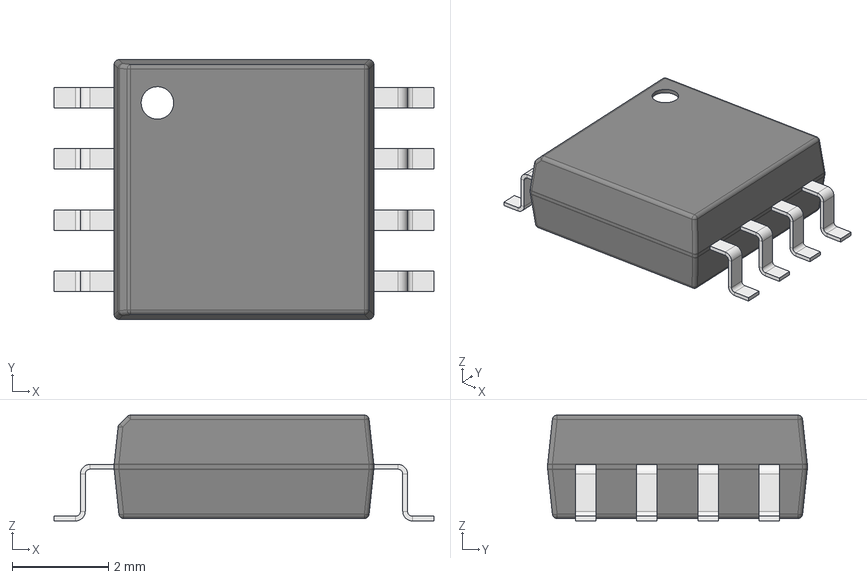
[picture p49: CAD file, 2025-05-21]
PCB_Schematic/KiCad/Bluetooth/ALTIUM_EMBEDDED_MODELS/SOP127P600-8N.step
7.90 x 5.40 x 2.20 mm
Leader x 8
