Prototype-Fund-Hardware/MYND-Hardware/PCB_Schematic/KiCad/Main/ALTIUM_EMBEDDED_MODELS/User Library-INDC2012X___.step

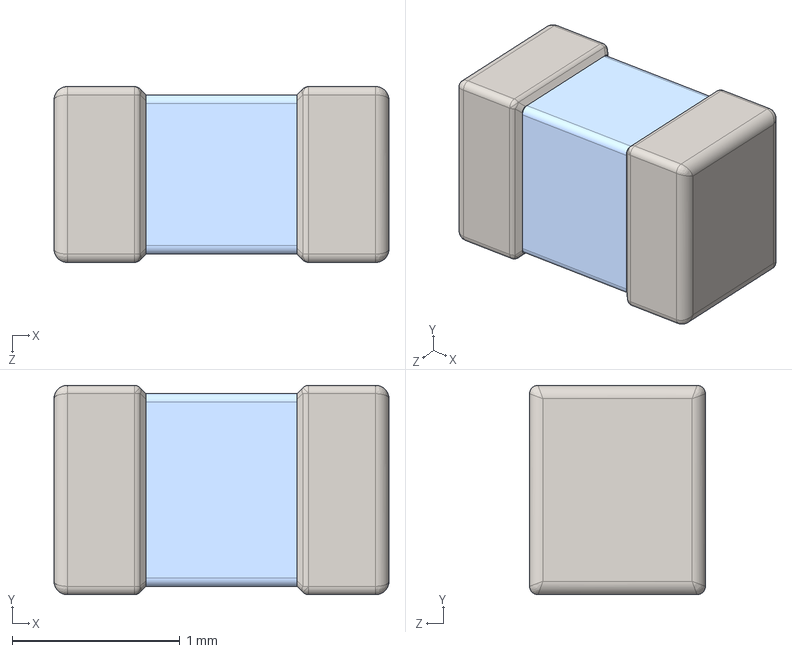
[picture p50: CAD file, 2025-05-21]
PCB_Schematic/KiCad/Main/ALTIUM_EMBEDDED_MODELS/User Library-INDC2012X___.step
2.00 x 1.25 x 1.05 mm
