Prototype-Fund-Hardware/MYND-Hardware/PCB_Schematic/KiCad/UI/ALTIUM_EMBEDDED_MODELS/LED_RGB_1608.step

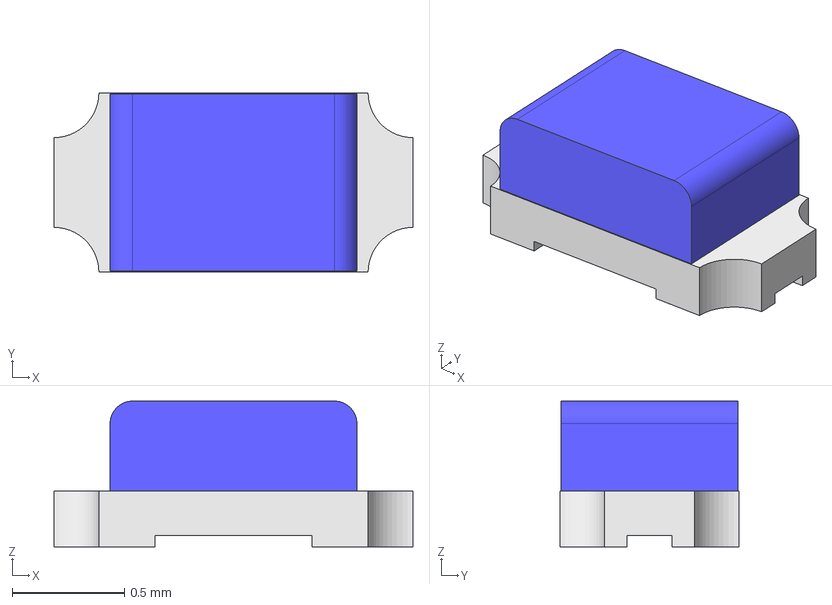
[picture p52: CAD file, 2025-05-21]
PCB_Schematic/KiCad/UI/ALTIUM_EMBEDDED_MODELS/LED_RGB_1608.step
1.60 x 0.8 x 0.65 mm
