Prototype-Fund-Hardware/MYND-Hardware/PCB_Schematic/KiCad/Main/ALTIUM_EMBEDDED_MODELS/RGR0020A.stp

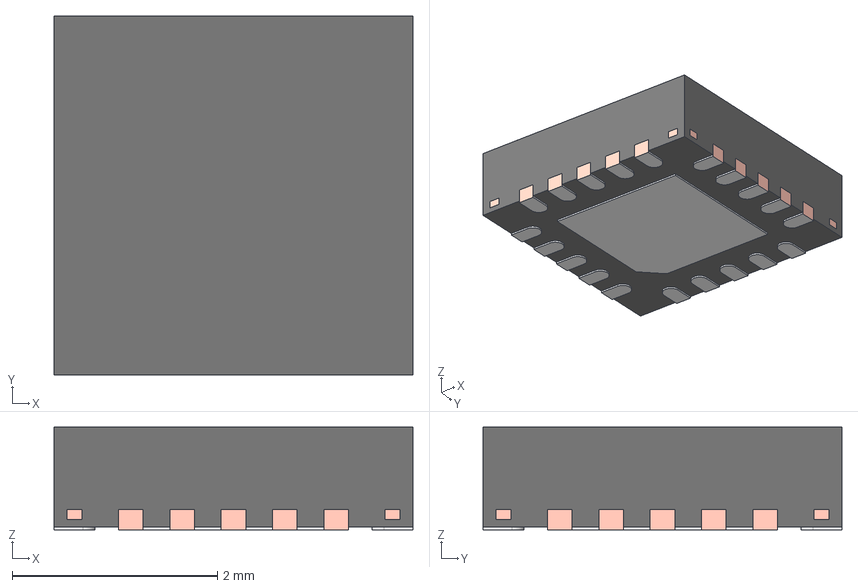
[picture p53: CAD file, 2025-05-21]
PCB_Schematic/KiCad/Main/ALTIUM_EMBEDDED_MODELS/RGR0020A.stp
3.50 x 3.50 x 1.00 mm
FRAME
PIN1_AREA
