Prototype-Fund-Hardware/MYND-Hardware/PCB_Schematic/KiCad/Bluetooth/ALTIUM_EMBEDDED_MODELS/User Library-RESC2012X___.STEP

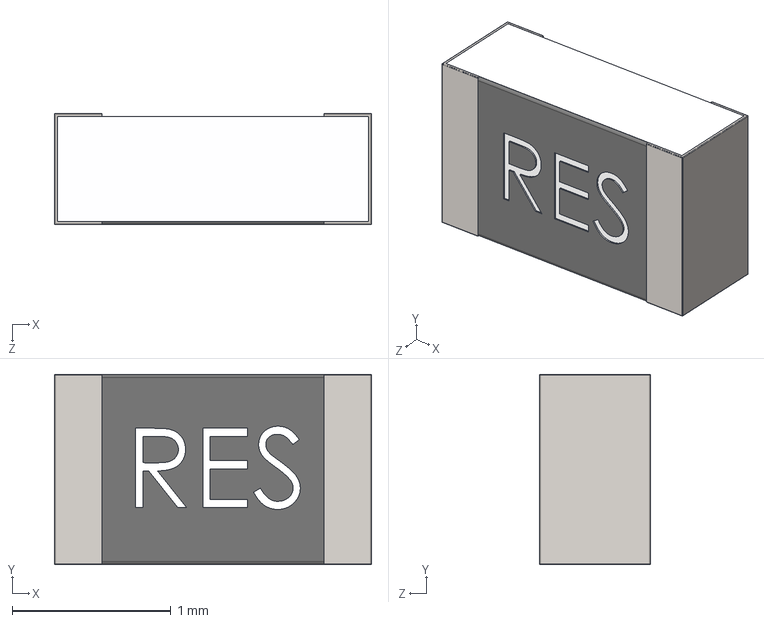
[picture p56: CAD file, 2025-05-21]
PCB_Schematic/KiCad/Bluetooth/ALTIUM_EMBEDDED_MODELS/User Library-RESC2012X___.STEP
2.00 x 1.20 x 0.7 mm
