Prototype-Fund-Hardware/MYND-Hardware/PCB_Schematic/KiCad/Main/ALTIUM_EMBEDDED_MODELS/User Library-SOD-123_DiodesInc.STEP

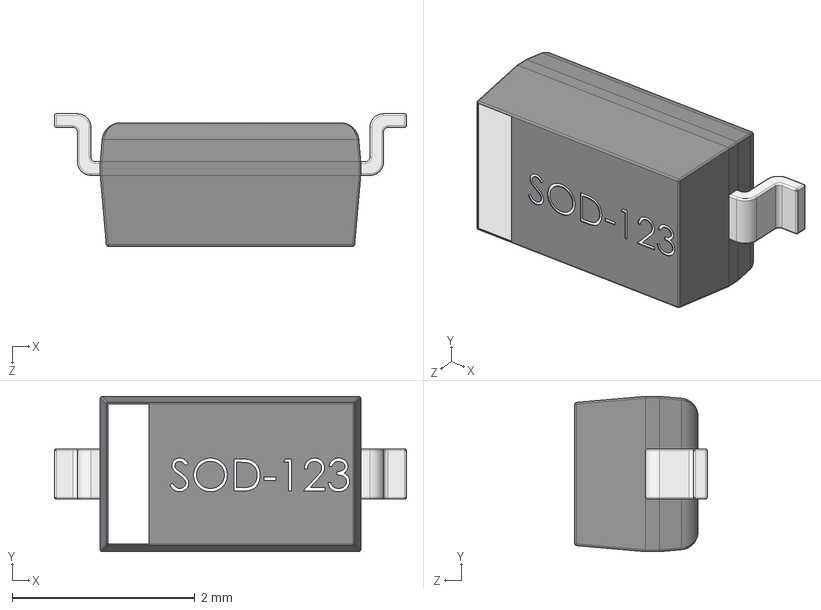
[picture p57: CAD file, 2025-05-21]
PCB_Schematic/KiCad/Main/ALTIUM_EMBEDDED_MODELS/User Library-SOD-123_DiodesInc.STEP
3.85 x 1.70 x 1.45 mm
