Prototype-Fund-Hardware/MYND-Hardware/PCB_Schematic/KiCad/Main/ALTIUM_EMBEDDED_MODELS/6.3x5.4_Chip.stp

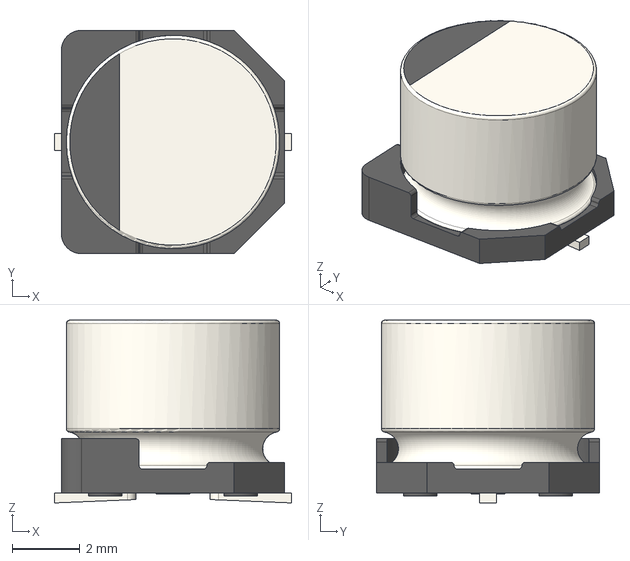
[picture p62: CAD file, 2025-05-21]
PCB_Schematic/KiCad/Main/ALTIUM_EMBEDDED_MODELS/6.3x5.4_Chip.stp
7.00 x 6.60 x 5.40 mm
