Prototype-Fund-Hardware/MYND-Hardware/PCB_Schematic/KiCad/Main/ALTIUM_EMBEDDED_MODELS/RSN0032B.stp

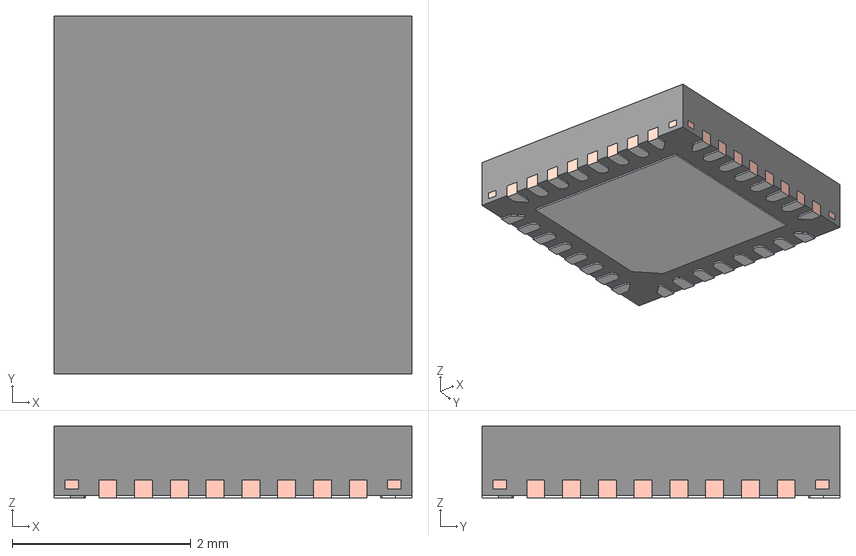
[picture p63: CAD file, 2025-05-21]
PCB_Schematic/KiCad/Main/ALTIUM_EMBEDDED_MODELS/RSN0032B.stp
4.00 x 4.00 x 0.8 mm
BODY-QFN
FRAME-RSN0032B
PIN1-ID
