Prototype-Fund-Hardware/MYND-Hardware/PCB_Schematic/KiCad/Main/ALTIUM_EMBEDDED_MODELS/20-wtb-a-double-row-st-smt-2x5p(1).stp

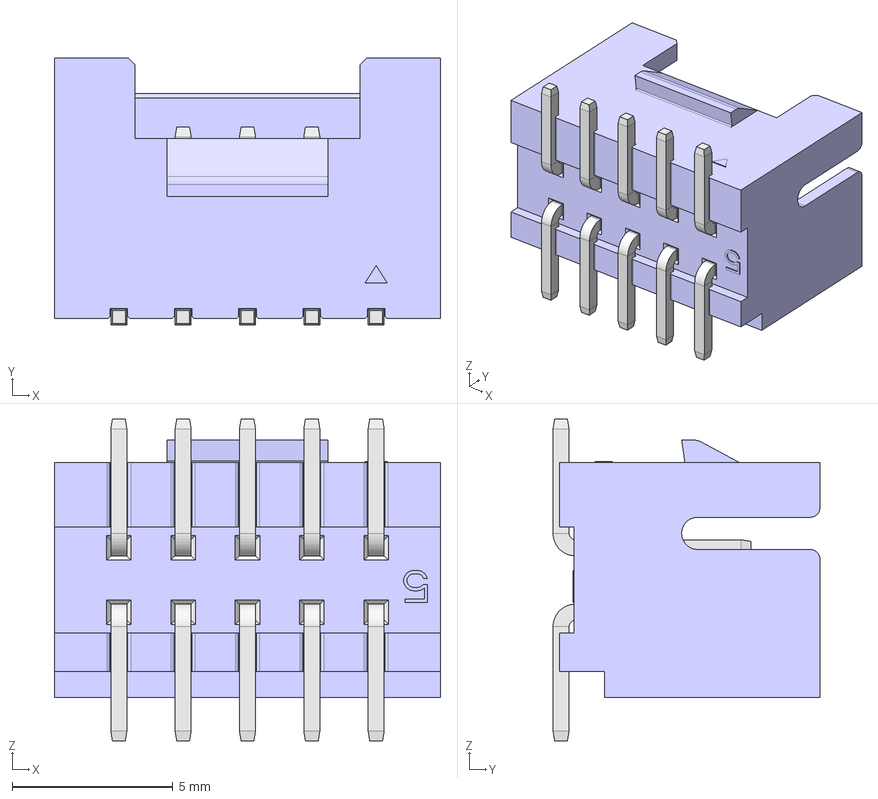
[picture p64: CAD file, 2025-05-21]
PCB_Schematic/KiCad/Main/ALTIUM_EMBEDDED_MODELS/20-wtb-a-double-row-st-smt-2x5p(1).stp
12.0 x 8.30 x 10.0 mm
