Prototype-Fund-Hardware/MYND-Hardware/PCB_Schematic/Altium/Main/ALTIUM_EMBEDDED_MODELS/DGK0008A.stp

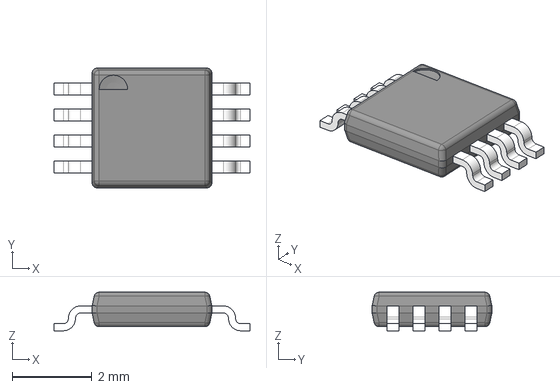
[picture p65: CAD file, 2025-05-21]
PCB_Schematic/Altium/Main/ALTIUM_EMBEDDED_MODELS/DGK0008A.stp
4.90 x 3.00 x 0.965 mm
BODY_MUA08A
LEAD_MUA08A x 8
