Prototype-Fund-Hardware/MYND-Hardware/PCB_Schematic/Altium/Main/ALTIUM_EMBEDDED_MODELS/LQFP64_1000X1000X160_50.step

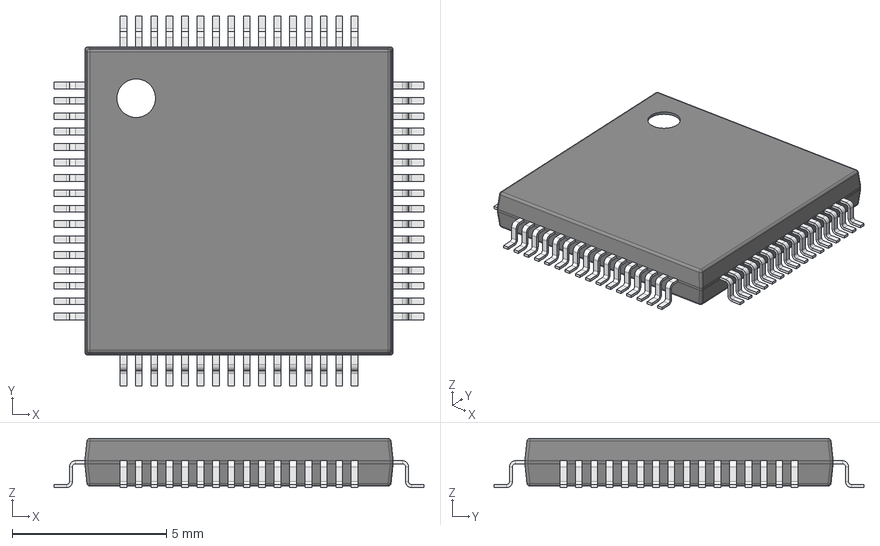
[picture p66: CAD file, 2025-05-21]
PCB_Schematic/Altium/Main/ALTIUM_EMBEDDED_MODELS/LQFP64_1000X1000X160_50.step
12.0 x 12.0 x 1.60 mm
Leader x 64
