Prototype-Fund-Hardware/MYND-Hardware/(list of files, cad)

Other CAD files:
CAD/3DM/MYND Print parts HMI cover.3dm
CAD/3DM/MYND Print parts Port housing.3dm
CAD/3DM/MYND Print parts Rubber HMI pad.3dm
CAD/3DM/MYND Print parts Rubber feet.3dm
CAD/3DM/MYND Print parts Rubber inserts.3dm
CAD/3DM/MYND Print parts Rubber sealing.3dm
PCB_Schematic/Altium/Main/ALTIUM_EMBEDDED_MODELS/610024243021 (rev1).stp
PCB_Schematic/Altium/Main/ALTIUM_EMBEDDED_MODELS/744231061_Download_STP_WE-CNSW-0805_rev1.stp
PCB_Schematic/KiCad/Amp/ALTIUM_EMBEDDED_MODELS/61001021821 (rev1).stp
PCB_Schematic/KiCad/Amp/ALTIUM_EMBEDDED_MODELS/61002421121 (rev1).stp
PCB_Schematic/KiCad/Bluetooth/ALTIUM_EMBEDDED_MODELS/61002421121 (rev1).stp
PCB_Schematic/KiCad/Jack_USB/ALTIUM_EMBEDDED_MODELS/744231061_Download_STP_WE-CNSW-0805_rev1.stp
PCB_Schematic/KiCad/Main/ALTIUM_EMBEDDED_MODELS/610024243021 (rev1).stp
PCB_Schematic/KiCad/Main/ALTIUM_EMBEDDED_MODELS/744231061_Download_STP_WE-CNSW-0805_rev1.stp
PCB_Schematic/KiCad/UI/ALTIUM_EMBEDDED_MODELS/43439.stp
