Prototype-Fund-Hardware/MYND-Hardware/(list of files, drawings)

Other design files:
PCB_Schematic/Altium/Amp/Mynd_AMP.PrjPcb
PCB_Schematic/Altium/Amp/Mynd_TI_AMP.SchDoc
PCB_Schematic/Altium/Bluetooth/Mynd_BT.PrjPcb
PCB_Schematic/Altium/Bluetooth/Mynd_BT.SchDoc
PCB_Schematic/Altium/Conn_Amp/Mynd_Conn.PcbDoc
PCB_Schematic/Altium/Conn_Amp/Mynd_CONN.PrjPcb
PCB_Schematic/Altium/Conn_Amp/Mynd_Conn.SchDoc
PCB_Schematic/Altium/Conn_Baffle/Mynd_BAFFLE.PrjPcb
PCB_Schematic/Altium/Conn_Baffle/Mynd_Baffle.SchDoc
PCB_Schematic/Altium/Conn_Bat/Mynd_BATT.PrjPcb
PCB_Schematic/Altium/Conn_Bat/Mynd_Batt.SchDoc
PCB_Schematic/Altium/Jack_Line_In/Mynd_LINE_IN_JACK.PrjPcb
PCB_Schematic/Altium/Jack_Line_In/Mynd_LINE_IN_JACK.SchDoc
PCB_Schematic/Altium/Jack_USB/Mynd_USB_JACK.PcbDoc
PCB_Schematic/Altium/Jack_USB/Mynd_USB_JACK.PrjPcb
PCB_Schematic/Altium/Jack_USB/Mynd_USB_JACK.SchDoc
PCB_Schematic/Altium/Main/Audio_Det.SchDoc
PCB_Schematic/Altium/Main/Boost_LM5123.SchDoc
PCB_Schematic/Altium/Main/Charger_BQ25713.SchDoc
PCB_Schematic/Altium/Main/MCU.SchDoc
PCB_Schematic/Altium/Main/Mynd_Main.PrjPcb
PCB_Schematic/Altium/Main/Mynd_Main.SchDoc
PCB_Schematic/Altium/Main/USB.SchDoc
PCB_Schematic/Altium/UI/Mynd_UI.PrjPcb
PCB_Schematic/Altium/UI/Mynd_UI.SchDoc
