Prototype-Fund-Hardware/MYND-Hardware/PCB_Schematic/KiCad/Conn_Baffle/Mynd_Baffle.kicad_pcb

## KiCad design PCB_Schematic/KiCad/Conn_Baffle/Mynd_Baffle.kicad_pcb (2025-05-21)

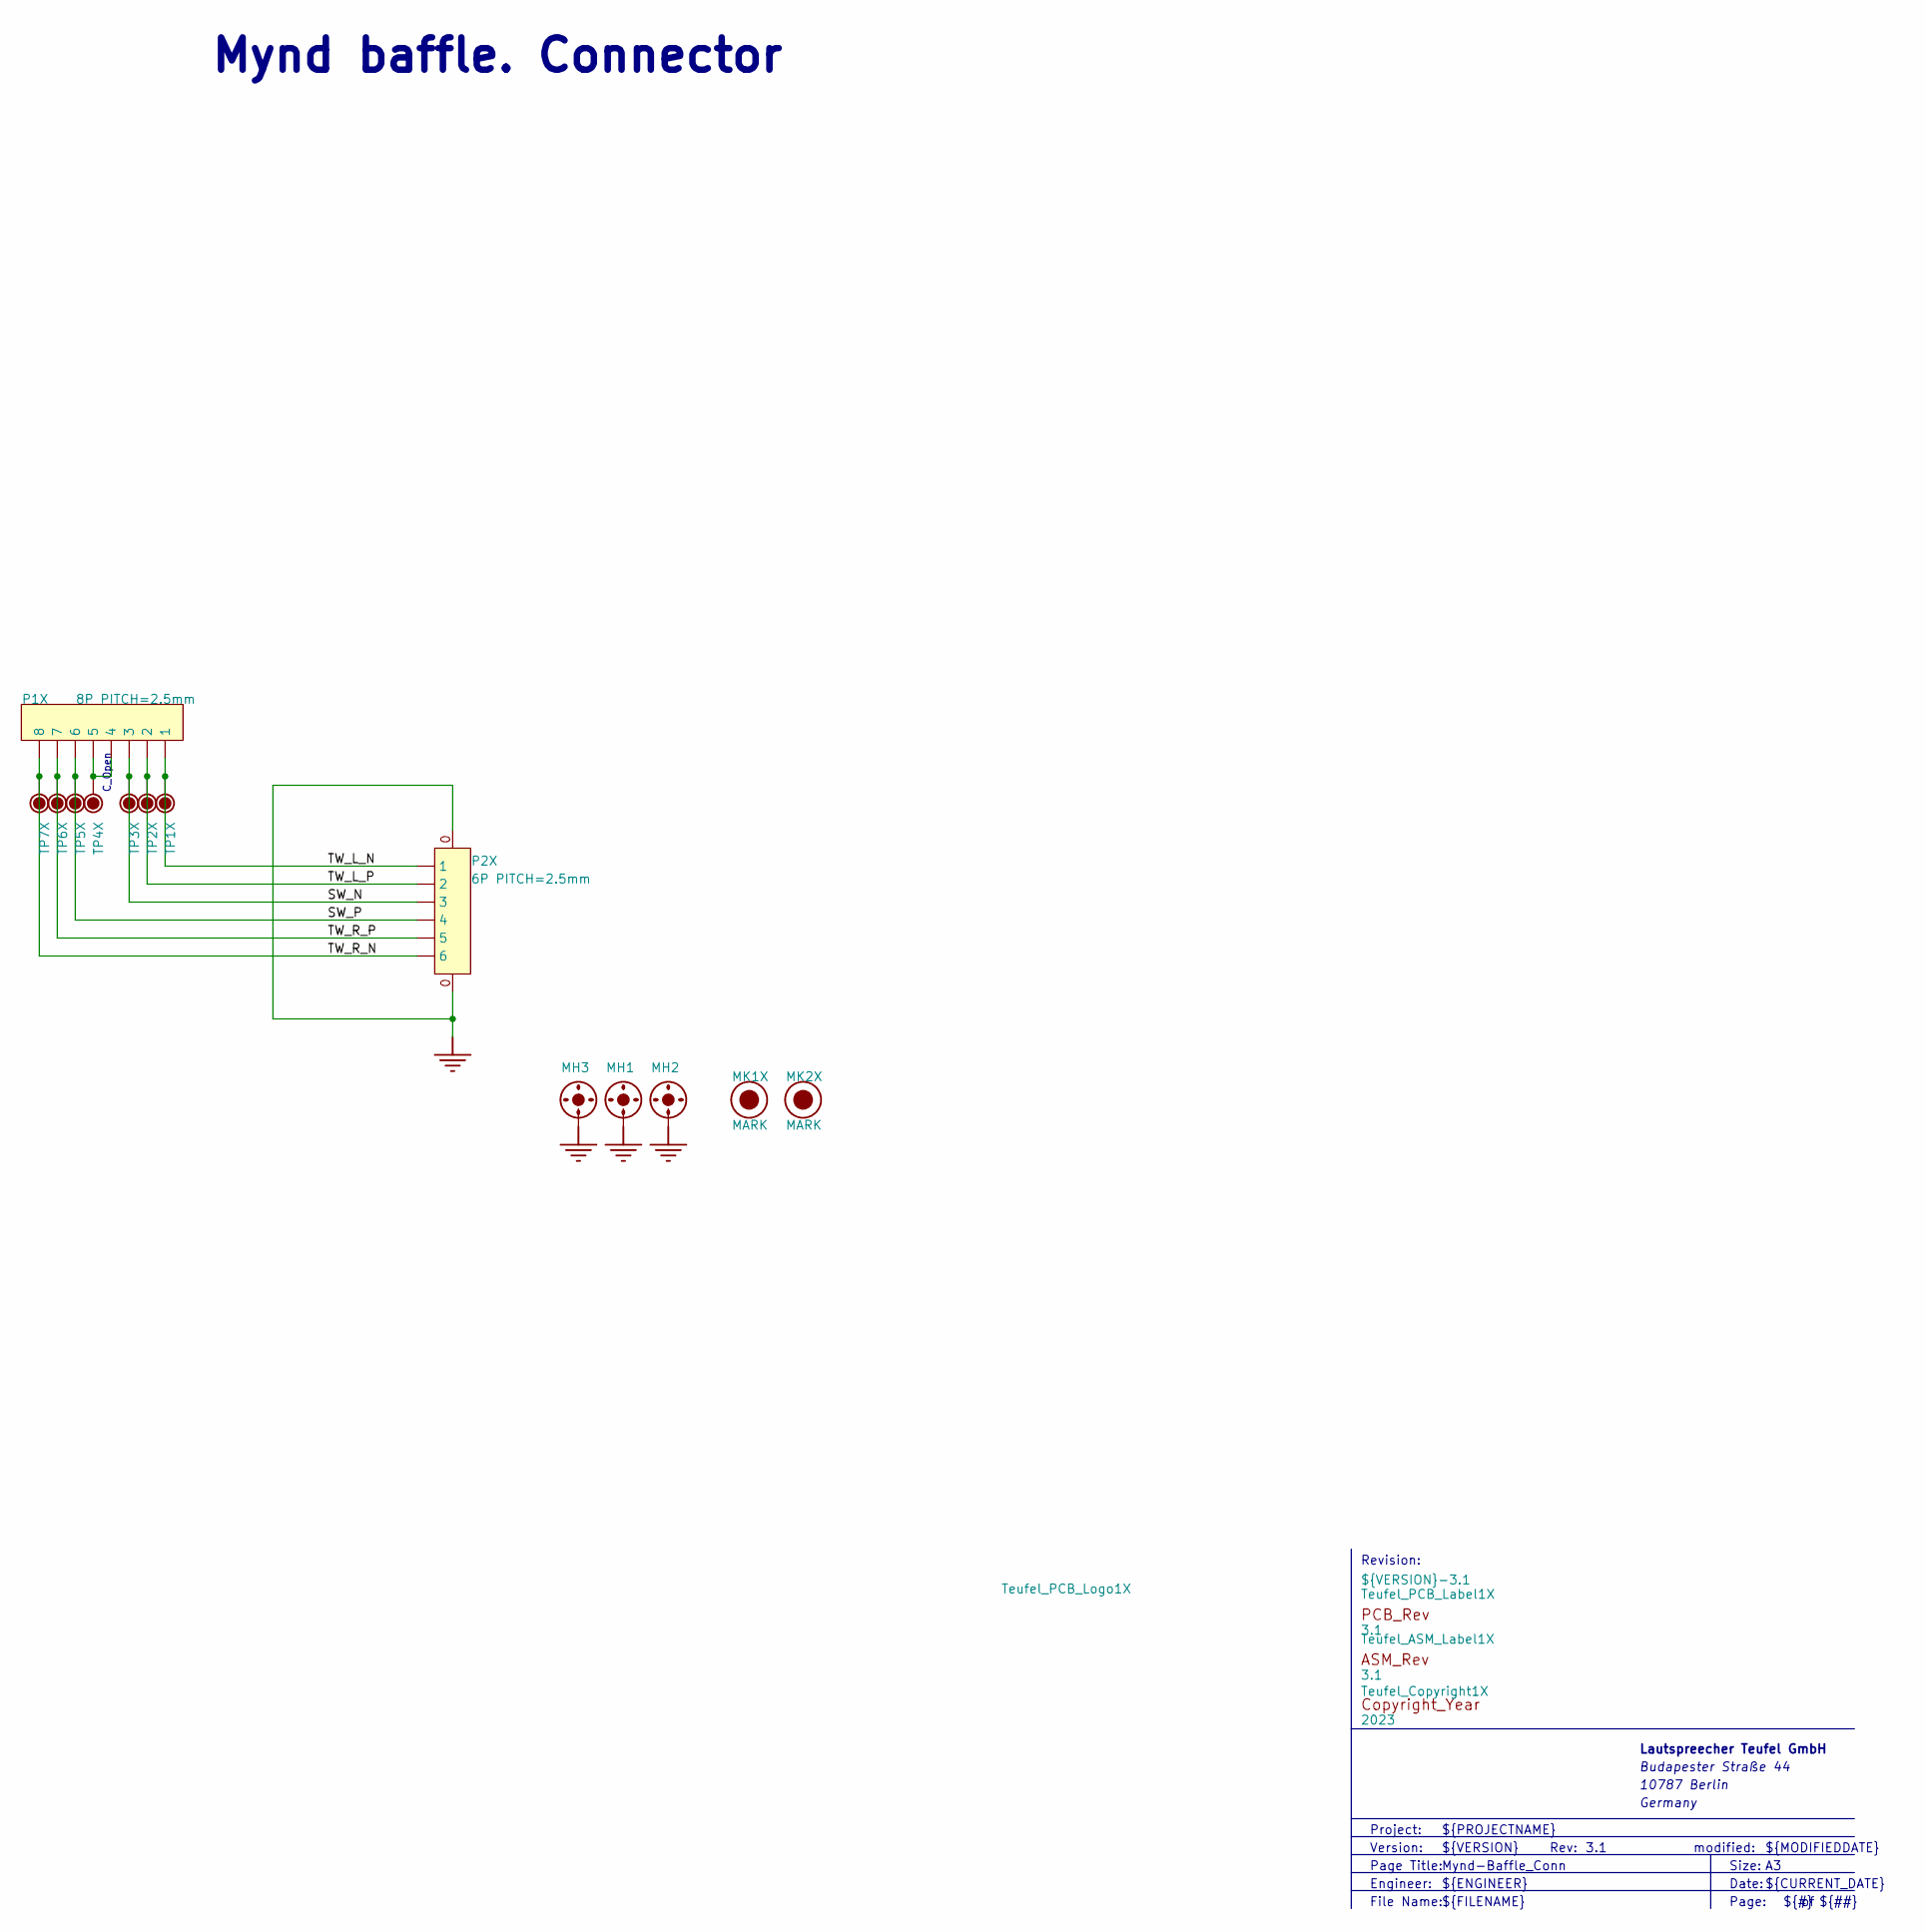
[picture p67: schematic Mynd_Baffle.kicad_sch, Mynd-Baffle_Conn]

Parts:
MH1, MH3: SCREW_HOLE_D35; SCREW_D35
MH2: HOLD_D35
MK1X, MK2X: MARK
P1X: 8P PITCH=2.5mm; TSB1_05282; PART_NUMBER 8P PITCH=2.5mm
P2X: 6P PITCH=2.5mm; CON_250_SMD_V_6P; PART_NUMBER 6P PITCH=2.5mm
TP1X, TP2X, TP3X, TP4X, TP5X, TP6X, TP7X: TP12; TP120
Teufel_ASM_Label1X: 3.1; Teufel_ASM_Rev
Teufel_Copyright1X: 2023; TEUFEL_COPYRIGHT
Teufel_PCB_Label1X: 3.1; Teufel_PCB_Rev
Teufel_PCB_Logo1X: ${VERSION}-${REVISION}; Teufel_NoLogo

Connections:
GND: MH1.1, MH2.1, MH3.1, P2X.0
NetP1X_4: P1X.4, P1X.5, TP4X.1
SW_N: P1X.3, P2X.3, TP3X.1
SW_P: P1X.6, P2X.4, TP5X.1
TW_L_N: P1X.1, P2X.1, TP1X.1
TW_L_P: P1X.2, P2X.2, TP2X.1
TW_R_N: P1X.8, P2X.6, TP7X.1
TW_R_P: P1X.7, P2X.5, TP6X.1

Notes on the sheet:
modified:
C_Open
${CURRENT_DATE}
Mynd baffle. Connector
Version:
Date:
File Name:
Page Title:
${FILENAME}
${MODIFIEDDATE}
Lautspreecher Teufel GmbH
Engineer:
${TITLE}
10787 Berlin
Budapester Straße 44
${##}
${ENGINEER}
Project:
Rev:
${PROJECTNAME}
${REVISION}
${VERSION}
Revision:
${#}
Size:
Page:
Germany

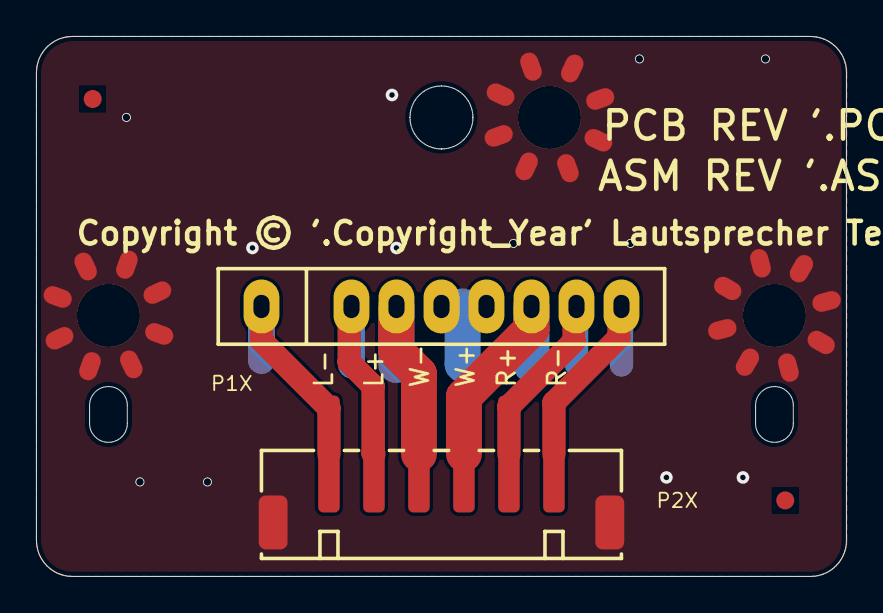
[picture p68: board Mynd_Baffle.kicad_pcb from above]

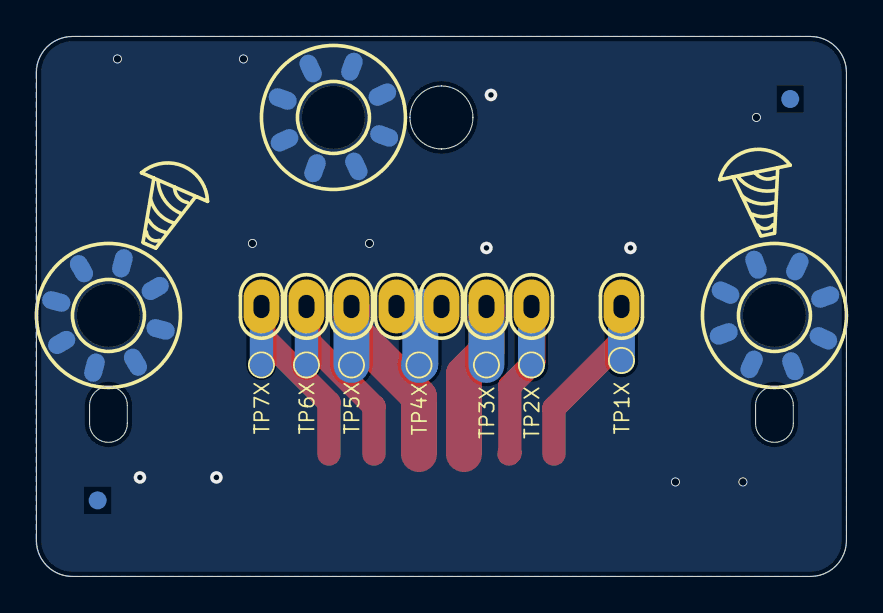
[picture p69: board Mynd_Baffle.kicad_pcb from below]

Board: 2 copper layers, 45.0 x 30.0 mm, 18 parts (10 on the bottom side), 8 nets.
