Prototype-Fund-Hardware/MYND-Hardware/PCB_Schematic/KiCad/Amp/Mynd_AMP.kicad_pcb

## KiCad design PCB_Schematic/KiCad/Amp/Mynd_AMP.kicad_pcb (2025-05-21)

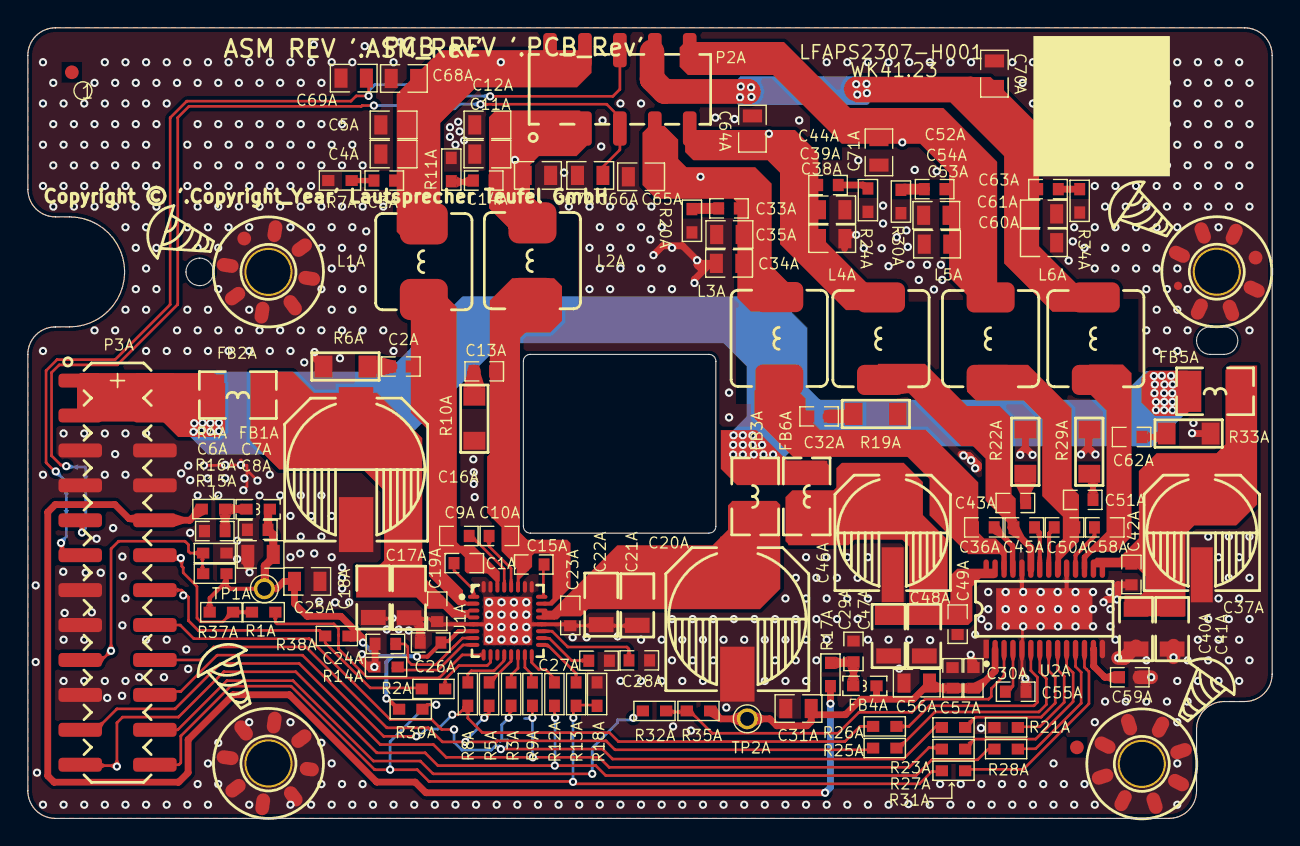
[picture p70: board Mynd_AMP.kicad_pcb from above]

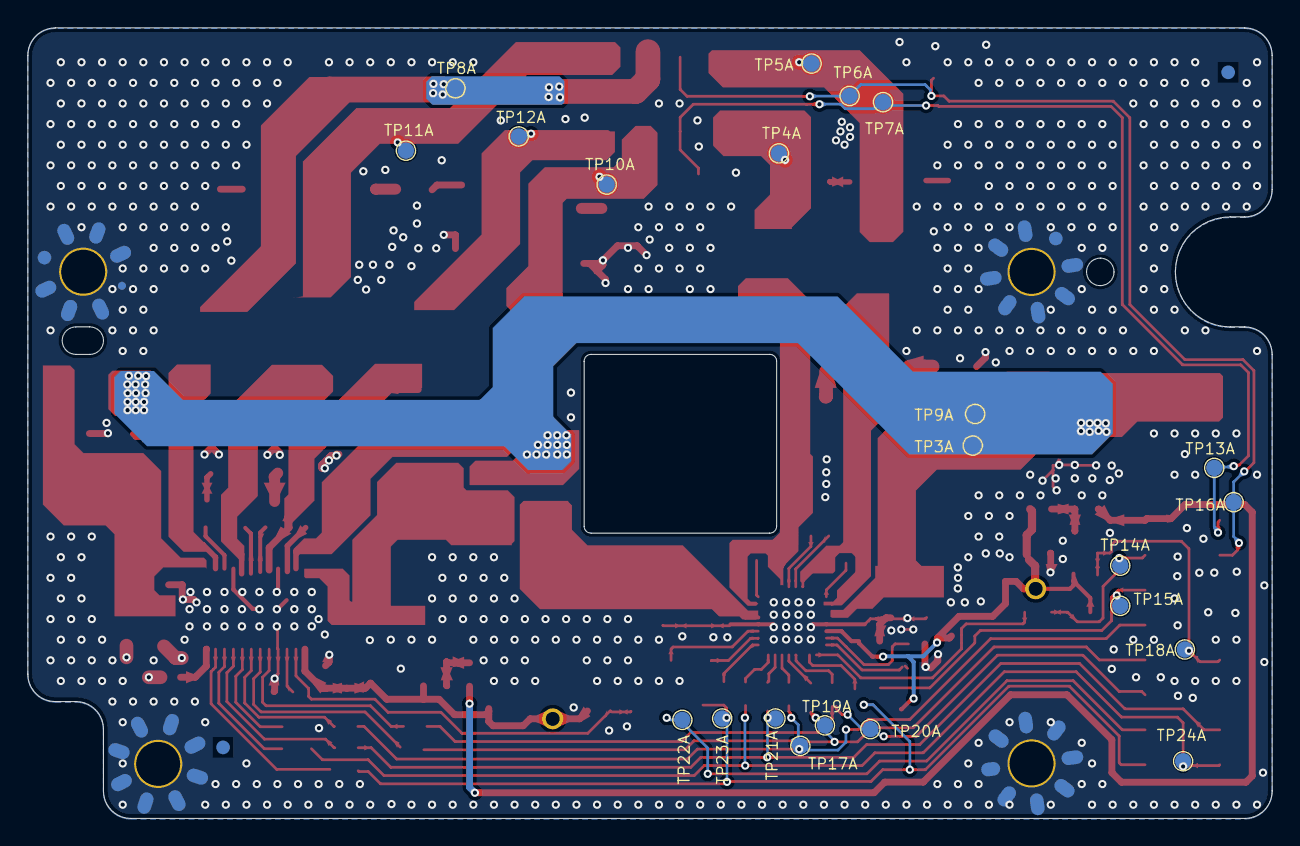
[picture p71: board Mynd_AMP.kicad_pcb from below]

Board: 2 copper layers, 90.5 x 57.5 mm, 159 parts (22 on the bottom side), 77 nets.

Parts:
C1A, C9A, C10A, C15A: 470nF; C0603X100
C2A, C13A, C32A, C43A, C51A, C62A: 330pF; C0603X80
C3A, C14A, C33A, C44A, C52A, C63A: 10nF; C0603X100
C4A, C11A: 680nF; C0805_125
C5A, C12A, C35A, C39A, C54A, C61A, C64A, C65A, C66A, C67A, C68A, C69A, C70A, C71A: 1nF; C0805_125
C6A, C7A, C19A, C23A, C26A, C29A, C30A, C42A, C49A, C57A: 100nF; C0603X105
C8A, C31A: 22uF; C0805_145
C16A, C20A: 470uF; ECAP_SMD_1000X1000
C17A, C18A, C21A, C22A, C40A, C41A, C47A, C48A: 10uF; C1206
C24A, C27A, C28A, C55A, C59A: 1uF; C0603X105
C25A, C56A: 4.7uF; C0805_145
C34A, C38A, C53A, C60A: 330nF; C0805_125
C36A, C45A, C50A, C58A: 220nF; C0603X100
C37A, C46A: 220uF; ECAP_SMD_800X1000
FB1A, FB4A: 600R; L0603
FB2A, FB3A, FB5A, FB6A: 56R; L1612
L1A, L2A: 4.7uH; IND_SMD_YT_SQU_L78XW70XH50
L3A, L4A, L5A, L6A: 10uH; IND_SMD_YT_SQU_L78XW70XH30
MH1A, MH2A, MH3A, MH4A: SCREW_HOLE_D32; SCREW_D32
MK_T1A, MK_T2A: MARK
P2A: 2 x 5P 2.54mm; female_2X5_254
P3A: 2 x 12P 2.54mm; Pin_Header_SMD_2X12_254
R1A, R2A, R13A, R31A, R32A: 10R; R0603
R3A, R5A, R8A, R9A, R12A, R14A, R23A, R25A, R26A, R27A, R28A: 0R; R0603
R4A, R17A: 2.2R; R0603
R6A, R10A, R19A, R22A, R29A, R33A: 10R; R1206
R7A, R11A, R20A, R24A, R30A, R34A: 3.3R; R0603
R15A: 100k; R0603
R16A, R18A, R21A, R37A, R38A: 10k; R0603
R35A: 4.7k; R0603
R39A: NC; R0603
TP1A, TP2A: TP_T_60_40
TP3A, TP4A, TP5A, TP6A, TP7A, TP8A, TP9A, TP10A, TP11A, TP12A, TP13A, TP14A, TP15A, TP16A, TP17A, TP18A, TP19A, TP20A, TP21A, TP22A, TP23A, TP24A: TP12; TP120
Teufel_ASM_Label1A: =Comment/Name; Teufel_ASM_Rev
Teufel_Copyright1A: =Comment/Name; TEUFEL_COPYRIGHT
Teufel_PCB_Label1A: =Comment/Name; Teufel_PCB_Rev
Teufel_PCB_Logo1A: T.3.0.0040-2.1; Teufel_NoLogo
U1A: TAS5825PRHBR; QFN32_500X500X100_50_P350X350
U2A: TAS5805MPWPR; TSSOP28(PWP)

Connections:
3V3_STB: P3A.10, R4A.2, R17A.2
3V3_SW: C7A.1, C8A.1, C25A.1, C26A.1, FB1A.2, R15A.1, R37A.1, R38A.1, R39A.1, TP1A.1, U1A.6
3V3_TW: C30A.1, C31A.1, C56A.1, C57A.1, FB4A.2, R35A.1, TP2A.1, U2A.2
24V: FB2A.1, FB3A.1, FB5A.1, FB6A.2, P3A.1, P3A.2, P3A.3, P3A.4, TP3A.1, TP9A.1
Amp_Ver: P3A.17, R15A.2, R16A.1, TP18A.1
BatVCC: C66A.1, P2A.5, P3A.9, TP7A.1, TP13A.1
C_Open: C69A.1, P2A.6, P3A.11, TP6A.1, TP16A.1
Env_Track: P3A.14, R2A.2, R38A.2, TP15A.1
GND: C4A.2, C5A.2, C6A.2, C7A.2, C8A.2, C11A.2, C12A.2, C16A.2, C17A.2, C18A.2, C19A.2, C20A.2, C21A.2, C22A.2, C23A.2, C24A.1, C25A.2, C26A.2, C27A.1, C28A.1, C29A.2, C30A.2, C31A.2, C34A.2, C35A.2, C37A.2, C38A.2, C39A.2, C40A.2, C41A.2, C42A.2, C46A.2, C47A.2, C48A.2, C49A.2, C53A.2, C54A.2, C55A.1, C56A.2, C57A.2, C59A.1, C60A.2, C61A.2, C64A.2, C65A.2, C66A.2, C67A.2, C68A.2, C69A.2, C70A.2, C71A.2, MH1A.1, MH2A.1, MH3A.1, MH4A.1, P3A.5, P3A.6, P3A.7, P3A.8, P3A.13, P3A.15, P3A.19, R6A.2, R7A.2, R10A.1, R11A.2, R14A.1, R16A.2, R18A.2, R19A.2, R20A.2, R21A.2, R22A.1, R24A.2, R29A.2, R30A.2, R33A.1, R34A.2, U1A.0, U1A.5, U1A.20, U1A.25, U1A.26, U1A.31, U1A.32, U2A.0, U2A.1, U2A.5, U2A.14, U2A.19, U2A.24
I2S_BCLK: P3A.18, R5A.1, R25A.1, TP19A.1
I2S_DATA: P3A.16, R3A.1, R23A.1, TP17A.1
I2S_LRCK: P3A.20, R8A.1, R26A.1, TP20A.1
NetC1A_1: C1A.1, C2A.2, C9A.2, L1A.1, U1A.2, U1A.30
NetC1A_2: C1A.2, U1A.1
NetC2A_1: C2A.1, R6A.1
NetC3A_2: C3A.2, R7A.1
NetC6A_1: C6A.1, FB1A.1, R4A.1
NetC9A_1: C9A.1, U1A.29
NetC10A_1: C10A.1, C13A.1, C15A.2, L2A.1, U1A.23, U1A.27
NetC10A_2: C10A.2, U1A.28
NetC13A_2: C13A.2, R10A.2
NetC14A_1: C14A.1, R11A.1
NetC15A_1: C15A.1, U1A.24
NetC16A_1: C16A.1, C17A.1, C18A.1, C19A.1, FB2A.2, U1A.3, U1A.4
NetC20A_1: C20A.1, C21A.1, C22A.1, C23A.1, FB3A.2, U1A.21, U1A.22
NetC24A_2: C24A.2, U1A.7
NetC27A_2: C27A.2, U1A.18
NetC28A_2: C28A.2, U1A.19
NetC29A_1: C29A.1, FB4A.1, R17A.1
NetC32A_1: C32A.1, R19A.1
NetC32A_2: C32A.2, C36A.1, L3A.1, U2A.26
NetC33A_2: C33A.2, R20A.1
NetC36A_2: C36A.2, U2A.25
NetC37A_1: C37A.1, C40A.1, C41A.1, C42A.1, FB5A.2, U2A.15, U2A.16
NetC43A_1: C43A.1, C45A.2, L4A.1, U2A.23
NetC43A_2: C43A.2, R22A.2
NetC44A_1: C44A.1, R24A.1
NetC45A_1: C45A.1, U2A.22
NetC46A_1: C46A.1, C47A.1, C48A.1, C49A.1, FB6A.1, U2A.27, U2A.28
NetC50A_1: C50A.1, C51A.2, L5A.1, U2A.20
NetC50A_2: C50A.2, U2A.21
NetC51A_1: C51A.1, R29A.1
NetC52A_2: C52A.2, R30A.1
NetC55A_2: C55A.2, U2A.4
NetC58A_1: C58A.1, U2A.18
NetC58A_2: C58A.2, C62A.1, L6A.1, U2A.17
NetC59A_2: C59A.2, U2A.13
NetC62A_2: C62A.2, R33A.2
NetC63A_1: C63A.1, R34A.1
NetR1A_1: R1A.1, U1A.9
NetR2A_1: R2A.1, U1A.10
NetR3A_2: R3A.2, U1A.14
NetR5A_2: R5A.2, U1A.13
NetR8A_2: R8A.2, U1A.12
NetR9A_2: R9A.2, U1A.15
NetR12A_2: R12A.2, U1A.16
NetR13A_1: R13A.1, U1A.17
NetR14A_2: R14A.2, U1A.8
NetR21A_1: R21A.1, U2A.9
NetR23A_2: R23A.2, U2A.8
NetR25A_2: R25A.2, U2A.7
NetR26A_2: R26A.2, U2A.6
NetR27A_2: R27A.2, U2A.10
NetR28A_2: R28A.2, U2A.11
NetR31A_1: R31A.1, U2A.12
NetR32A_1: R32A.1, R35A.2, U2A.3
SCL: P3A.23, R12A.1, R28A.1, TP24A.1
SDA: P3A.21, R9A.1, R27A.1, TP21A.1
SW_N: C11A.1, C12A.1, C14A.2, C67A.1, L2A.2, P2A.1, P2A.3, TP4A.1
SW_P: C3A.1, C4A.1, C5A.1, C68A.1, L1A.2, P2A.2, P2A.4, TP5A.1
TW_L_N: C52A.1, C53A.1, C54A.1, C71A.1, L5A.2, P2A.10, TP11A.1
TW_L_P: C60A.1, C61A.1, C63A.2, C70A.1, L6A.2, P2A.8, TP8A.1
TW_R_N: C38A.1, C39A.1, C44A.2, C64A.1, L4A.2, P2A.9, TP12A.1
TW_R_P: C33A.1, C34A.1, C35A.1, C65A.1, L3A.2, P2A.7, TP10A.1
~Amp_PDN: P3A.24, R13A.2, R18A.1, R31A.2, R39A.2, TP23A.1
~Amp_SwFlt: P3A.12, R1A.2, R37A.2, TP14A.1
~Amp_TwFlt: P3A.22, R32A.2, TP22A.1
