Prototype-Fund-Hardware/MYND-Hardware/PCB_Schematic/KiCad/Conn_Amp/Mynd_Conn.kicad_pcb

## KiCad design PCB_Schematic/KiCad/Conn_Amp/Mynd_Conn.kicad_pcb (2025-05-21)

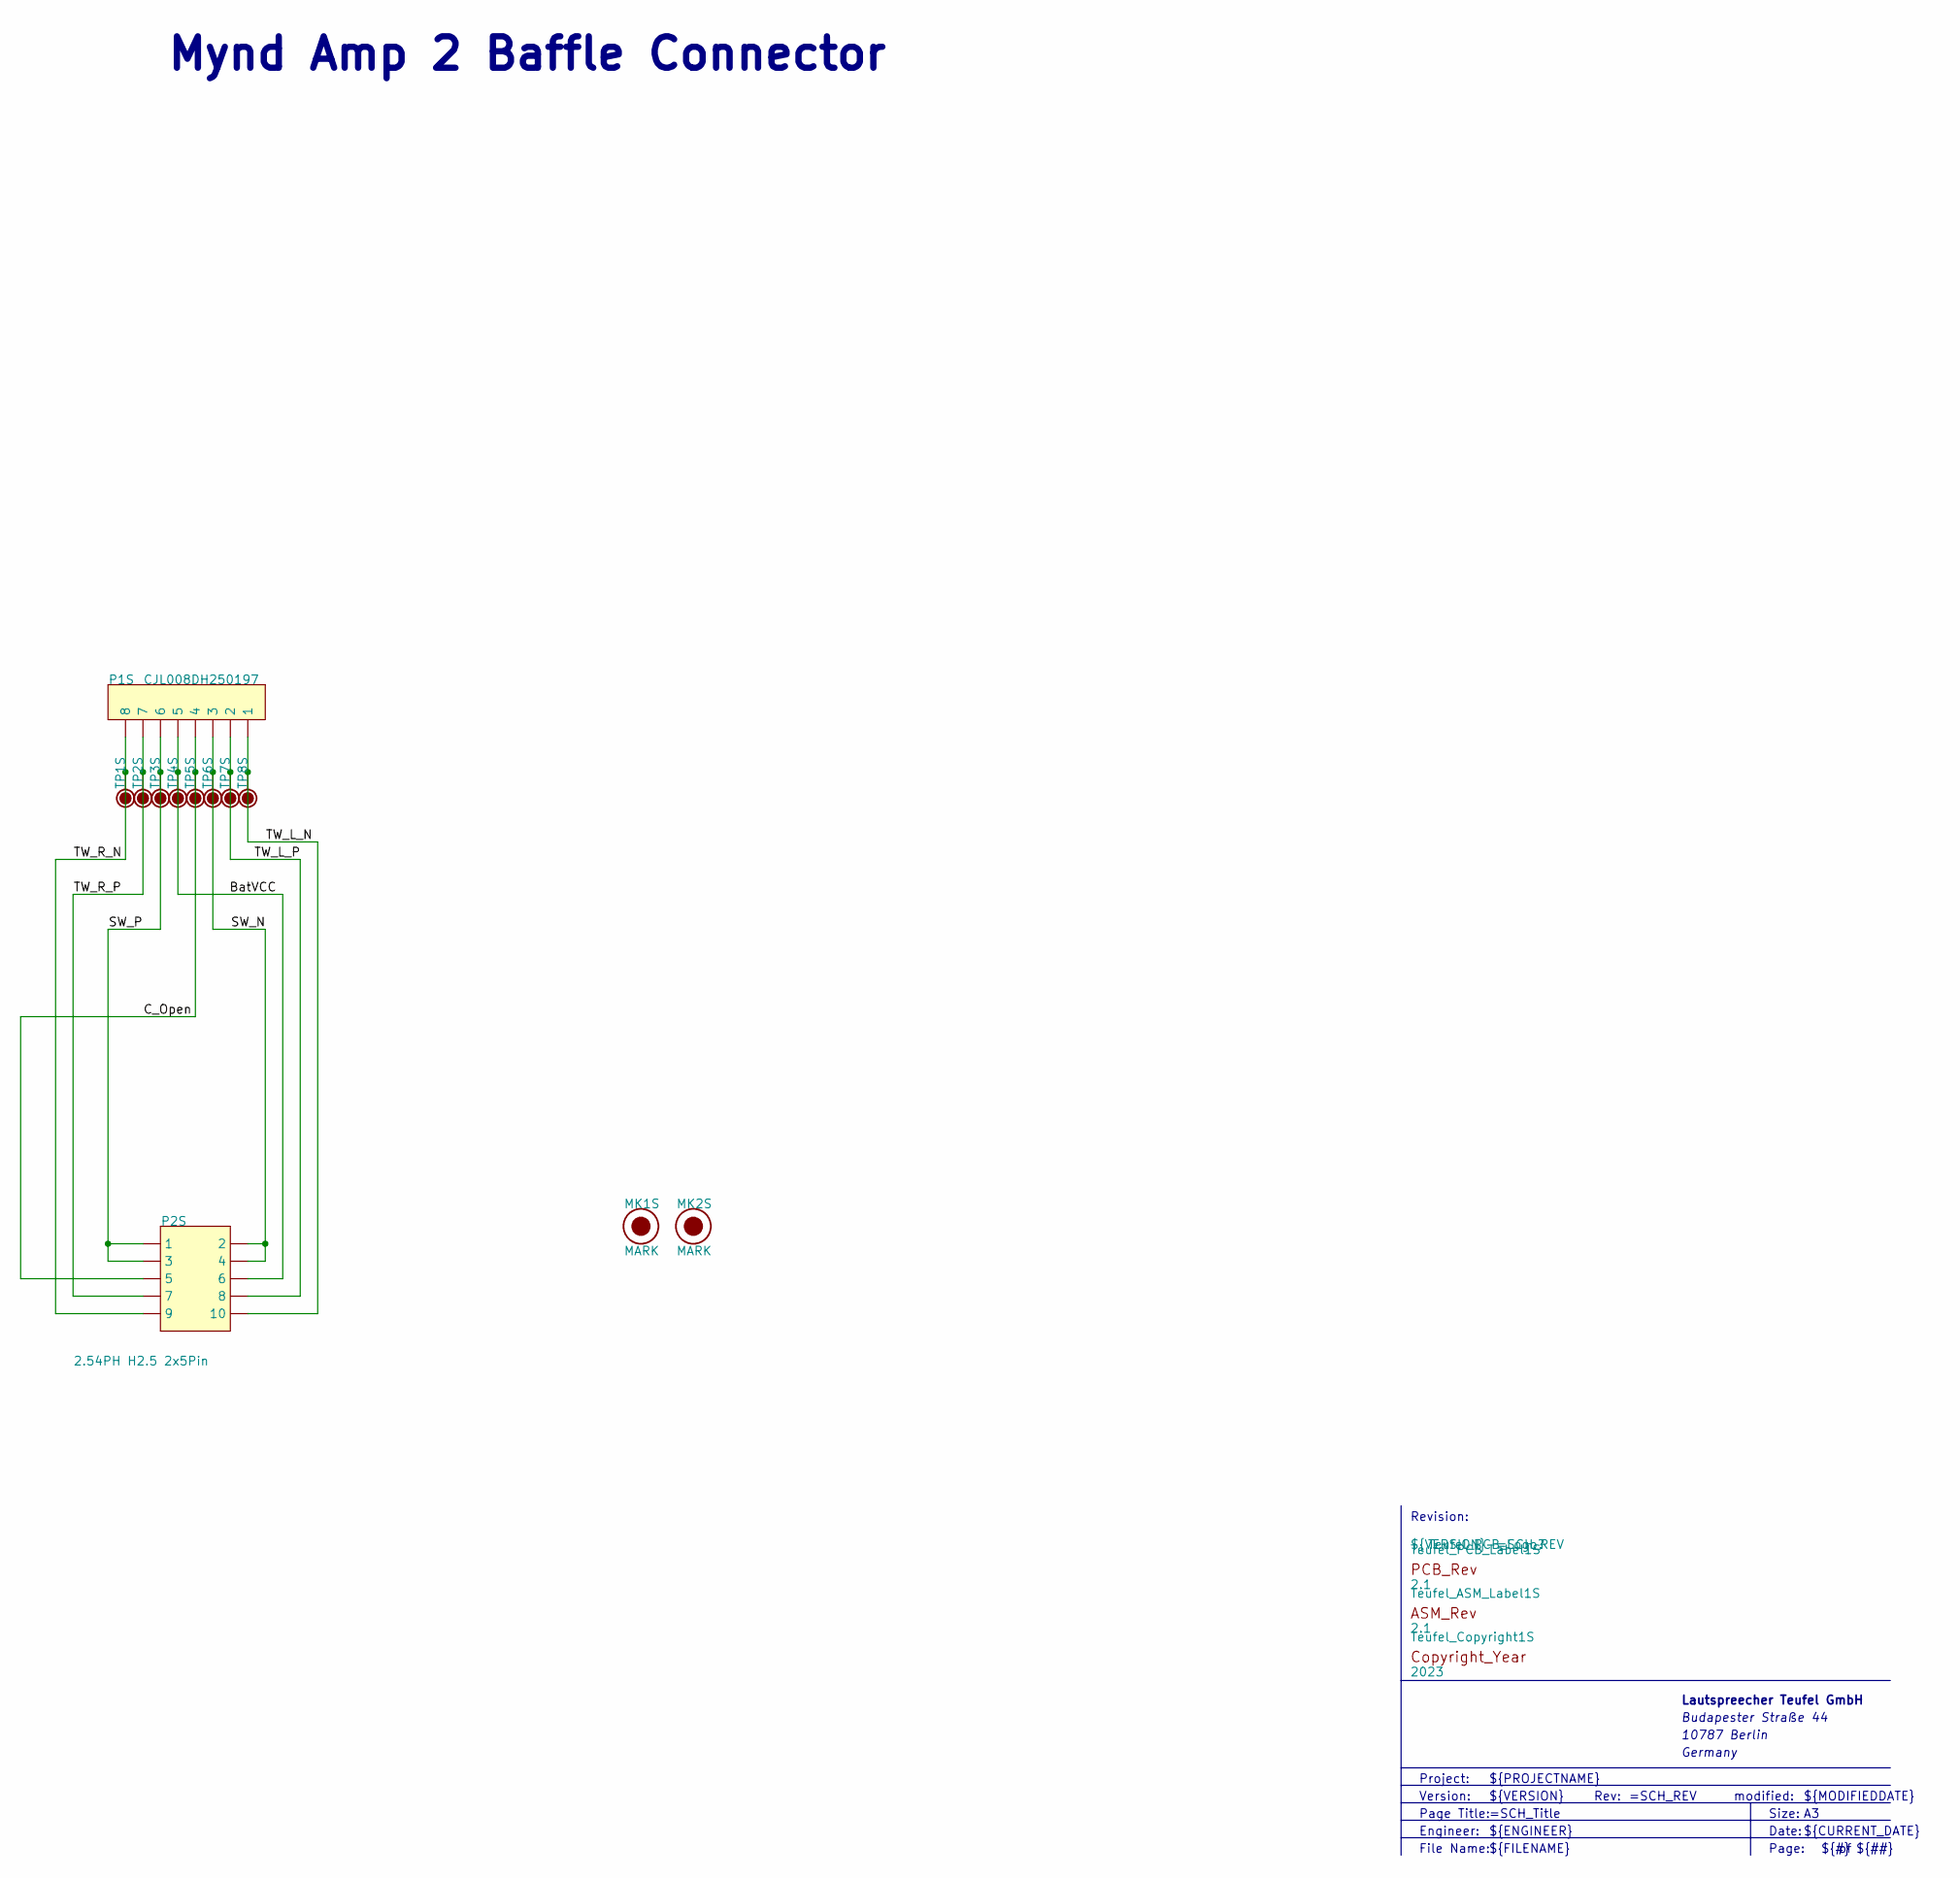
[picture p72: schematic Mynd_Conn.kicad_sch, =SCH_Title]

Parts:
MK1S, MK2S: MARK
P1S: CJL008DH250197; PART_NUMBER CJL008DH250197
P2S: 2.54PH H2.5 2x5Pin; Pin_Header_SMD_Side_2X5_254; PART_NUMBER 2.54PH H2.5 2x5Pin
TP1S, TP2S, TP3S, TP4S, TP5S, TP6S, TP7S, TP8S: TP12; TP120
Teufel_ASM_Label1S: 2.1; Teufel_ASM_Rev
Teufel_Copyright1S: 2023; Teufel_Copyright
Teufel_PCB_Label1S: 2.1; Teufel_PCB_Rev

Connections:
BatVCC: P1S.5, P2S.6, TP4S.1
C_Open: P1S.4, P2S.5, TP5S.1
SW_N: P1S.3, P2S.2, P2S.4, TP6S.1
SW_P: P1S.6, P2S.1, P2S.3, TP3S.1
TW_L_N: P1S.1, P2S.10, TP8S.1
TW_L_P: P1S.2, P2S.8, TP7S.1
TW_R_N: P1S.8, P2S.9, TP1S.1
TW_R_P: P1S.7, P2S.7, TP2S.1

Notes on the sheet:
Mynd Amp 2 Baffle Connector
${FILENAME}
Date:
Version:
Germany
Size:
Page Title:
${PROJECTNAME}
Lautspreecher Teufel GmbH
modified:
Budapester Straße 44
${REVISION}
${MODIFIEDDATE}
Revision:
Project:
${#}
Rev:
${ENGINEER}
File Name:
${CURRENT_DATE}
${VERSION}
Page:
${##}
Engineer:
${TITLE}
10787 Berlin

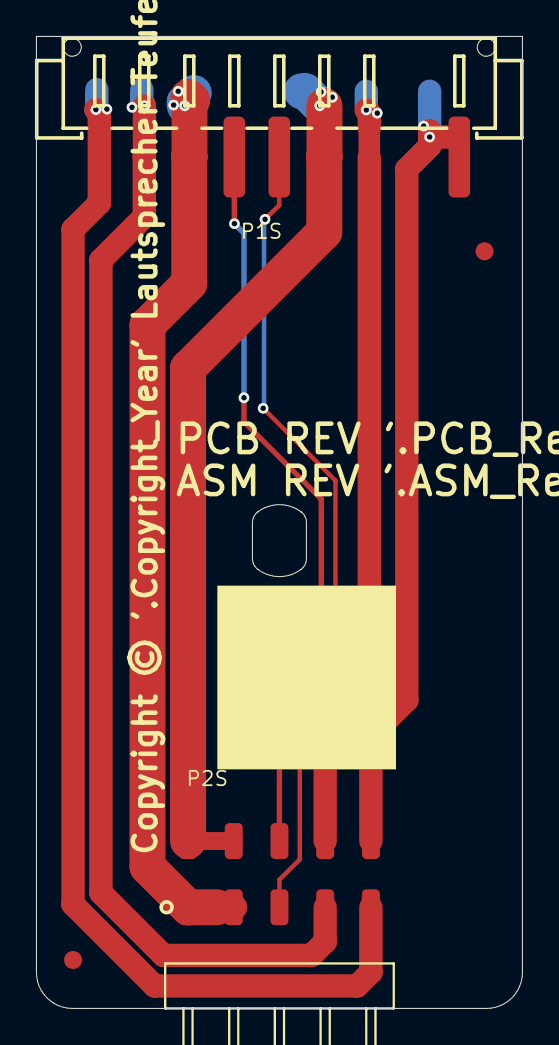
[picture p73: board Mynd_Conn.kicad_pcb from above]

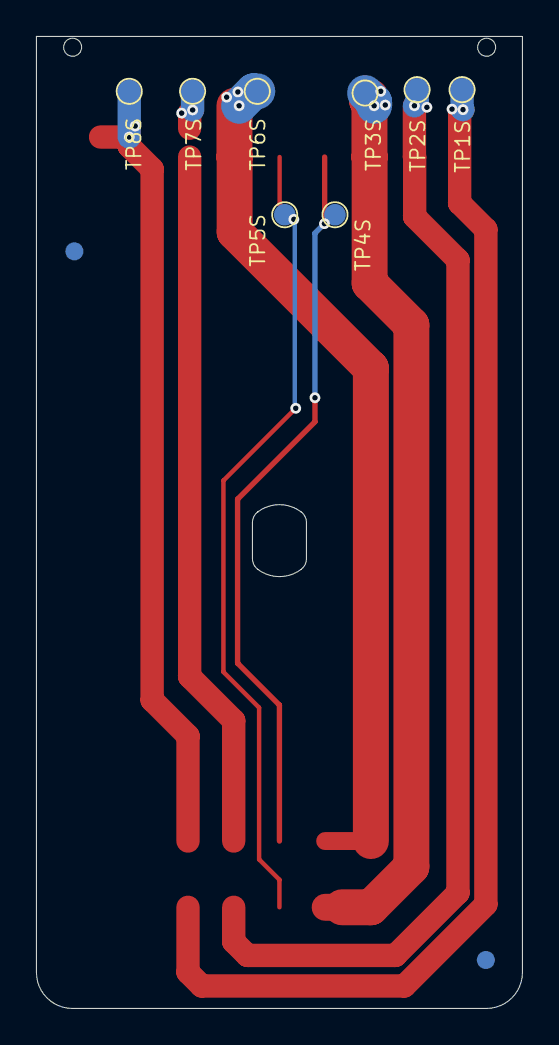
[picture p74: board Mynd_Conn.kicad_pcb from below]

Board: 2 copper layers, 27.0 x 54.0 mm, 16 parts (8 on the bottom side), 8 nets.

Other parts of the board:
Teufel_PCB_Logo?: T.3.0.0040-2.1; Teufel_NoLogo
