Prototype-Fund-Hardware/MYND-Hardware/PCB_Schematic/KiCad/UI/Mynd_UI.kicad_pcb

## KiCad design PCB_Schematic/KiCad/UI/Mynd_UI.kicad_pcb (2025-05-21)

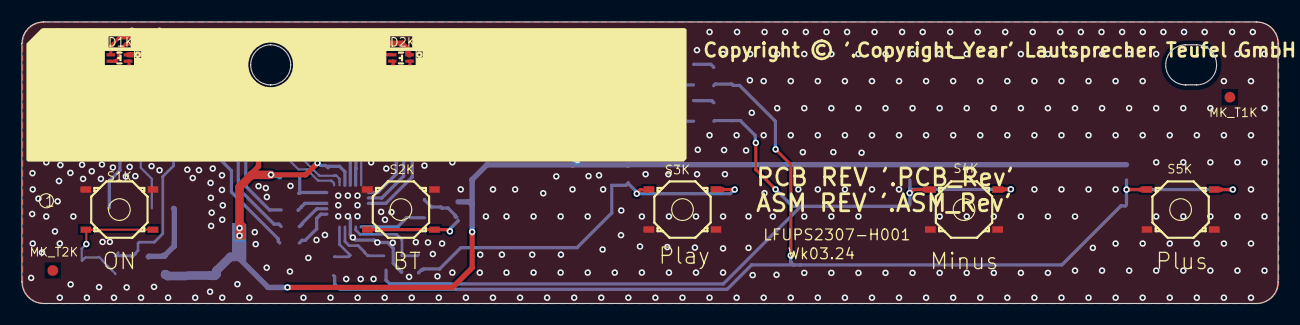
[picture p75: board Mynd_UI.kicad_pcb from above]

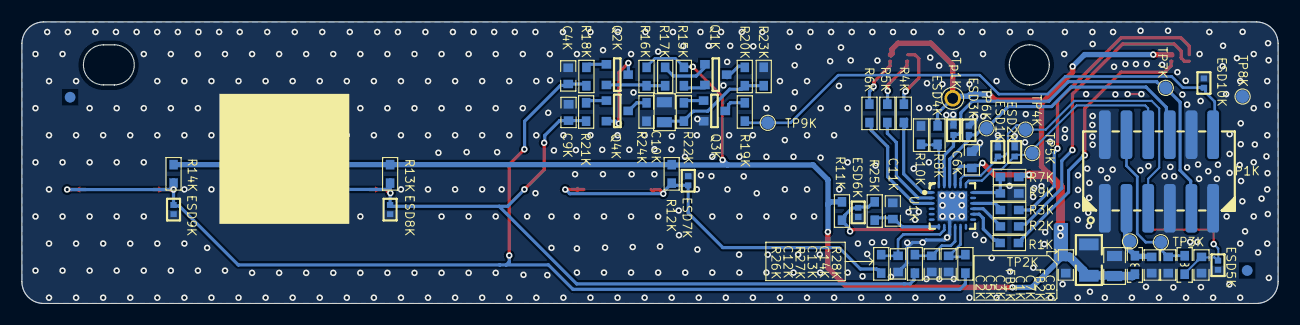
[picture p76: board Mynd_UI.kicad_pcb from below]

Board: 2 copper layers, 116.0 x 26.0 mm, 82 parts (69 on the bottom side), 43 nets.

Parts:
C1K, C2K, C4K, C6K, C9K: 100nF; C0603X100
C3K, C10K: 10uF; C0805_145
C5K: 22uF; C1206
C7K, C8K: 33pF; C0603X80
C11K, C12K, C13K, C14K: NC; C0603X100
D1K, D2K: JH-CRGBB06GTP014; LED_SMD_F_T_160X80X60
ESD1K, ESD2K, ESD3K, ESD4K, ESD6K, ESD7K, ESD8K, ESD9K, ESD10K: CESD0501CU; DFN2_100X60X50_65
ESD5K: BDFN2C121V; DFN2_100X60X50_65
FB1K, FB2K: 600R; L0603
MK_T1K, MK_T2K: MARK
P1K: WB200AL-12; WB200AL_2x6P
Q1K, Q2K, Q4K: CJ3401; SOT23-GSD
Q3K: 2N7002K; SOT23-GSD
R1K, R2K, R5K, R6K: 22R; R0603
R3K, R4K: 75R; R0603
R7K, R8K: 100R; R0603
R9K, R10K, R16K, R22K: 10k; R0603
R11K, R12K, R13K, R14K: 100k; R0603
R15K, R24K: 0R; R0603
R17K: 4.7k; R0603
R18K, R21K: 150k; R0603
R19K: 10R; R0603
R20K: 680k; R0603
R23K: 1M; R0603
R25K, R26K, R27K, R28K: 1k; R0603
S1K, S2K, S3K, S4K, S5K: TC-1316A-H1.5-180GF; TACT_SW_SMD_52X52X15
TP2K, TP3K, TP4K, TP5K, TP6K, TP7K, TP8K, TP9K: TP12; TP120
Teufel_ASM_Label1K: =Comment/Name; Teufel_ASM_Rev
Teufel_Copyright1K: =Comment/Name; TEUFEL_COPYRIGHT
Teufel_PCB_Label1K: =Comment/Name; Teufel_PCB_Rev
Teufel_PCB_Logo1K: T.3.0.0040-3.2; Teufel_NoLogo
Tp1K: TP_T_60_40
U1K: AW9523BTQR; QFN24_400X400X100_50_P270X270

Connections:
3V3_LED: C2K.1, C3K.1, C5K.2, C6K.2, D1K.C, D2K.C, FB1K.1, R7K.2, R8K.2, R11K.1, R12K.1, R13K.1, R14K.1, R15K.1, R16K.2, Tp1K.1, U1K.21
3V3_STB: C1K.1, FB1K.2, P1K.3, TP2K.1
Btn_BT: ESD6K.2, R11K.2, R25K.2, S2K.3, S2K.4
Btn_Minus: C9K.1, ESD8K.2, R13K.2, R21K.1, R27K.2, S4K.3, S4K.4
Btn_On: C8K.1, ESD5K.2, FB2K.2, S1K.3, S1K.4
Btn_Play: ESD7K.2, R12K.2, R26K.2, S3K.3, S3K.4
Btn_Plus: C4K.1, ESD9K.2, R14K.2, R18K.1, R28K.2, S5K.3, S5K.4
GND: C1K.2, C2K.2, C3K.2, C4K.2, C5K.1, C6K.1, C7K.2, C8K.2, C9K.2, C10K.2, C11K.2, C12K.2, C13K.2, C14K.2, ESD1K.1, ESD2K.1, ESD3K.1, ESD4K.1, ESD5K.1, ESD6K.1, ESD7K.1, ESD8K.1, ESD9K.1, ESD10K.1, P1K.1, P1K.2, P1K.7, P1K.10, P1K.11, Q3K.S, R9K.2, R10K.2, R23K.1, R24K.1, S1K.1, S1K.2, S2K.1, S2K.2, S3K.1, S3K.2, S4K.1, S4K.2, S5K.1, S5K.2, TP8K.1, U1K.0, U1K.9
I2C2_SCL: ESD2K.2, P1K.6, TP5K.1, U1K.19
I2C2_SDA: ESD1K.2, P1K.5, TP4K.1, U1K.20
MCU_RST: ESD10K.2, P1K.12, R19K.1, TP9K.1
NetC10K_1: C10K.1, R20K.2, R22K.1, R23K.2
NetC11K_1: C11K.1, R25K.1, U1K.7
NetC12K_1: C12K.1, R26K.1, U1K.8
NetC13K_1: C13K.1, R27K.1, U1K.10
NetC14K_1: C14K.1, R28K.1, U1K.11
NetD1K_B: D1K.B, R1K.1
NetD1K_G: D1K.G, R2K.1
NetD1K_R: D1K.R, R3K.1
NetD2K_B: D2K.B, R6K.1
NetD2K_G: D2K.G, R5K.1
NetD2K_R: D2K.R, R4K.1
NetQ1K_D: Q1K.D, R20K.1
NetQ1K_G: Q1K.G, R17K.2
NetQ1K_S: Q1K.S, R15K.2
NetQ2K_D: Q2K.D, Q4K.S
NetQ2K_G: Q2K.G, R18K.2
NetQ2K_S: Q2K.S, R16K.1, R17K.1
NetQ3K_D: Q3K.D, R19K.2
NetQ3K_G: Q3K.G, R22K.2
NetQ4K_D: Q4K.D, R24K.2
NetQ4K_G: Q4K.G, R21K.2
NetR1K_2: R1K.2, U1K.14
NetR2K_2: R2K.2, U1K.15
NetR3K_2: R3K.2, U1K.16
NetR4K_2: R4K.2, U1K.1
NetR5K_2: R5K.2, U1K.2
NetR6K_2: R6K.2, U1K.3
NetR7K_1: R7K.1, R9K.1, U1K.18
NetR8K_1: R8K.1, R10K.1, U1K.24
\P_Btn: C7K.1, FB2K.1, P1K.4, TP3K.1
\UI_Int: ESD3K.2, P1K.8, TP6K.1, U1K.22
\UI_Rst: ESD4K.2, P1K.9, TP7K.1, U1K.23
