Prototype-Fund-Hardware/MYND-Hardware/PCB_Schematic/KiCad/Bluetooth/Mynd_BT.kicad_pcb

## KiCad design PCB_Schematic/KiCad/Bluetooth/Mynd_BT.kicad_pcb (2025-05-21)

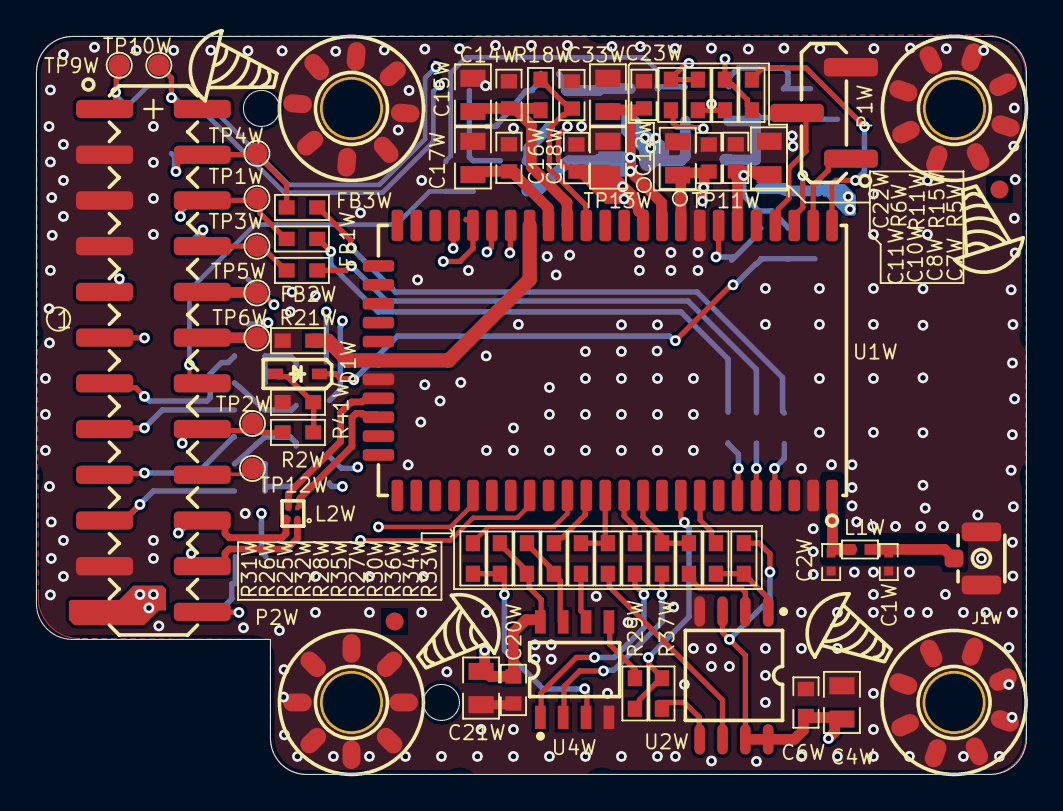
[picture p77: board Mynd_BT.kicad_pcb from above]

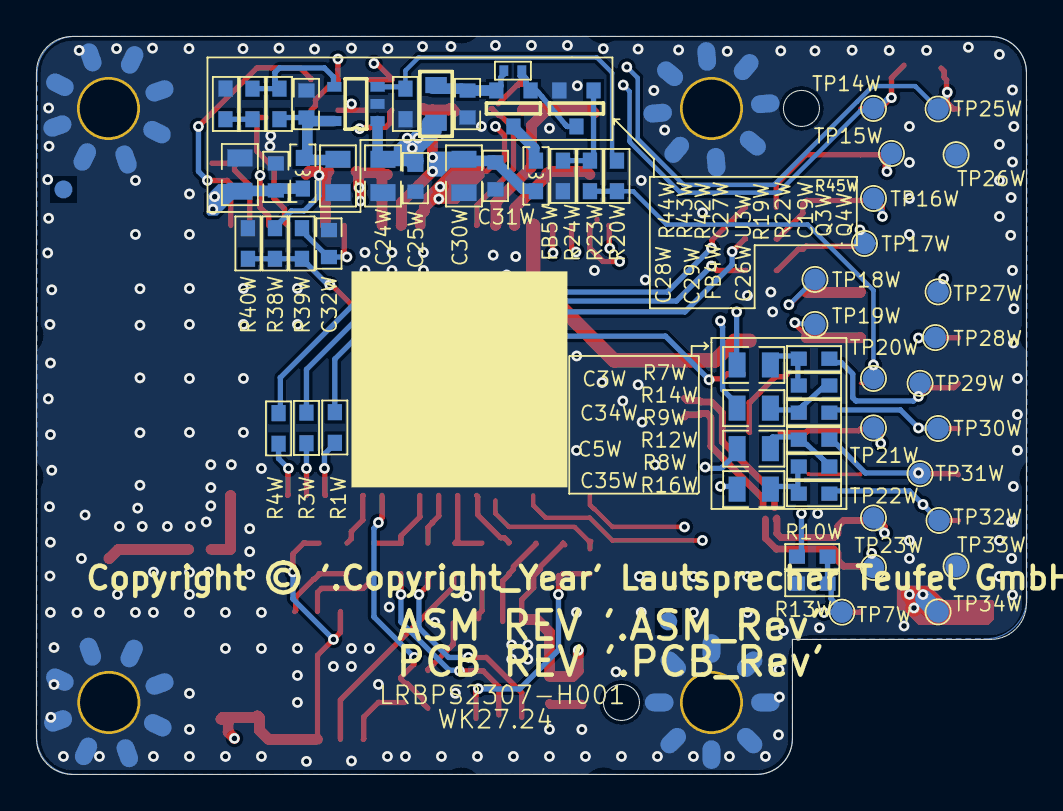
[picture p78: board Mynd_BT.kicad_pcb from below]

Board: 4 copper layers, 55.0 x 41.0 mm, 136 parts (66 on the bottom side), 79 nets.

Parts:
C1W, C2W: 0.5pF; C0402
C3W, C4W, C5W, C7W, C11W, C12W, C15W, C17W, C21W, C23W, C24W, C26W, C28W, C30W, C34W, C35W: 10uF; C0805_145
C6W, C8W, C10W, C14W, C16W, C18W, C19W, C20W, C22W, C25W, C27W, C29W, C31W: 100nF; C0603X100
C32W: 100pF; C0603X80
C33W: 1nF; C0603X100
D1W: 1N4148; SOD-323
FB1W, FB2W, FB3W: 0R; R0603
FB4W, FB5W: 600R; L0603
J1W: 9181-000030; I-PEX MHF
L1W: 0R; R0402
L2W: 90R; COM_CHOKE_SMD_ICMF062P
MH1W, MH2W, MH3W, MH4W: SCREW_HOLE; SCREW_D32
MK1W, MK2W: MARK
P1W: Header 3P PITCH=2.54mm SMT; Pin_Header_SMD_S_T_254_3P
P2W: Connector 2 x 12P 2.54mm SMT; Pin_Header_SMD_2X12_254
Q3W: CJ3401; SOT23-GSD
Q4W: 2N7002K; SOT23-GSD
R1W, R3W, R4W, R27W, R28W, R29W, R30W, R31W, R32W, R34W, R35W, R36W, R37W: 33R; R0603
R2W, R11W, R13W, R15W, R25W, R26W, R33W: 10k; R0603
R5W, R6W, R9W, R16W, R21W: 0R; R0603
R7W, R12W: 3.3k; R0603
R8W, R14W: 6.8k; R0603
R10W: 100k; R0603
R18W: 33k; R0603
R19W, R24W, R41W: 47k; R0603
R20W, R23W, R39W: 1k; R0603
R22W: 2.2R; R0805
R38W: 1M; R0603
R40W: 560k; R0603
R42W: 680k; R0603
R43W: 150k; R0603
R44W: 20k; R0603
R45W: 100k; R0402
TP1W, TP2W, TP3W, TP4W, TP5W, TP6W, TP7W, TP9W, TP10W, TP12W, TP14W, TP15W, TP16W, TP17W, TP18W, TP19W, TP20W, TP21W, TP22W, TP23W, TP25W, TP26W, TP27W, TP28W, TP29W, TP30W, TP31W, TP32W, TP33W, TP34W: TP12; TP120
TP11W, TP13W: TP06; TP060
Teufel_ASM_Label1W: =Comment/Name; Teufel_ASM_Rev
Teufel_Copyright1W: =Comment/Name; TEUFEL_COPYRIGHT
Teufel_PCB_Label1W: =Comment/Name; Teufel_PCB_Rev
Teufel_PCB_Logo1W: T.3.0.0040-3.1; Teufel_NoLogo
U1W: WB-2835P; BT_59P_L260XW150XH26_P105
U2W: RCI025064-B000; SO_8_200
U3W: SGM2036-ADJYN5G/TR; SOT23-5
U4W: APS6404L-3SQN; SO-8

Connections:
3V3_STB: P2W.11, R10W.1, TP28W.1
5V_CCPD: C24W.1, C25W.2, P2W.23, R22W.2, TP34W.1, U3W.1
AGND: R21W.2, U1W.30, U1W.43
BT_2_BCLK: FB1W.1, P2W.6, TP1W.1, TP16W.1
BT_2_LRCK: FB2W.1, P2W.8, TP3W.1, TP17W.1
BT_2_SDAT: FB3W.1, P2W.4, TP4W.1, TP15W.1
BT_AVCC: C16W.1, C17W.2, U1W.44
BT_Ctrl_Pwr: P2W.14, R20W.2, R23W.1, TP20W.1
BT_Ctrl_Vreg: P2W.18, TP12W.1
BT_RTCVDD: C7W.1, C8W.1, R38W.1, U1W.54
BT_SCL: P2W.2, R5W.1, R15W.2, TP10W.1, TP14W.1
BT_SDA: P2W.1, R6W.1, R11W.2, TP9W.1, TP25W.1
BT_SVCC: C14W.1, C15W.2, R18W.1, U1W.45
BT_VBAT: C10W.2, C11W.2, C28W.1, C29W.2, FB4W.2, TP11W.1, U1W.51
BT_VBUS: C22W.1, C23W.1, C30W.2, C31W.2, FB5W.2, TP13W.1, U1W.50
BT_VCC: C4W.2, C6W.2, C12W.2, C18W.2, C20W.1, C21W.1, R11W.1, R15W.1, R25W.1, R26W.1, R33W.1, U1W.49, U2W.3, U2W.7, U2W.8, U4W.8
BT_Ver: P2W.24, R10W.2, R13W.1, TP7W.1
BUD_N: L2W.4, U1W.28
BUD_P: L2W.3, U1W.27
FLASH_CS: R33W.2, R34W.2, U2W.1
FLASH_MISO: R36W.2, U2W.2
FLASH_MOSI: R37W.2, U2W.5
FLASH_SCLK: R35W.2, U2W.6
GND: C1W.2, C2W.2, C4W.1, C6W.1, C7W.2, C8W.2, C10W.1, C11W.1, C12W.1, C14W.2, C15W.1, C16W.2, C17W.1, C18W.1, C19W.2, C20W.2, C21W.2, C22W.2, C23W.2, C24W.2, C25W.1, C26W.2, C27W.1, C28W.2, C29W.1, C30W.1, C31W.1, C32W.1, C33W.1, J1W.2, MH1W.1, MH2W.1, MH3W.1, MH4W.1, P1W.3, P2W.3, P2W.5, P2W.7, P2W.21, Q4W.S, R13W.2, R19W.2, R21W.1, R24W.2, R40W.2, R41W.2, R44W.1, TP26W.1, TP33W.1, U1W.2, U1W.29, U1W.52, U2W.4, U3W.2, U4W.4
GPIO0: R5W.2, U1W.59
GPIO1: R6W.2, U1W.57
GPIO2/UART_RX: P1W.1, U1W.58
GPIO3/UART_TX: P1W.2, U1W.56
GPIO8: R27W.1, U1W.12
GPIO9: R28W.1, R35W.1, U1W.13
GPIO10: R30W.1, R36W.1, U1W.11
GPIO11: R29W.1, R37W.1, U1W.9
GPIO13: R32W.1, U1W.14
GPIO14: R31W.1, U1W.15
GPIO16: R34W.1, U1W.8
Line_L_N: P2W.15, R9W.2, TP30W.1
Line_L_P: P2W.13, R7W.2, TP29W.1
Line_R_N: P2W.19, R16W.2, TP32W.1
Line_R_P: P2W.17, R12W.2, TP31W.1
MCU_RX: P2W.10, TP5W.1, TP18W.1, U1W.20
MCU_TX: P2W.12, TP6W.1, TP19W.1, U1W.17
NetC1W_1: C1W.1, J1W.1, L1W.1
NetC2W_1: C2W.1, L1W.2, U1W.1
NetC3W_1: C3W.1, U1W.39
NetC3W_2: C3W.2, R7W.1, R14W.2
NetC5W_1: C5W.1, U1W.41
NetC5W_2: C5W.2, R8W.2, R12W.1
NetC19W_1: C19W.1, Q3W.S, R22W.1, R45W.1
NetC26W_1: C26W.1, C27W.2, FB4W.1, R42W.1, U3W.5
NetC32W_2: C32W.2, R39W.2, U1W.53
NetC33W_2: C33W.2, R18W.2, U1W.46
NetC34W_1: C34W.1, U1W.40
NetC34W_2: C34W.2, R9W.1, R14W.1
NetC35W_1: C35W.1, U1W.42
NetC35W_2: C35W.2, R8W.1, R16W.1
NetD1W_A: D1W.A, R2W.1, R41W.1
NetFB1W_2: FB1W.2, R1W.2
NetFB2W_2: FB2W.2, R3W.2
NetFB3W_2: FB3W.2, R4W.2
NetFB5W_1: FB5W.1, Q3W.D
NetQ3W_G: Q3W.G, Q4W.D, R45W.2
NetQ4W_G: Q4W.G, R23W.2, R24W.1
NetR1W_1: R1W.1, U1W.6
NetR3W_1: R3W.1, U1W.5
NetR4W_1: R4W.1, U1W.4
NetR19W_1: R19W.1, R20W.1, U3W.3
NetR42W_2: R42W.2, R43W.2, U3W.4
NetR43W_1: R43W.1, R44W.2
ON/OFF: D1W.K, R38W.2, R39W.1, R40W.1
PSRAM_CE: R27W.2, U4W.1
PSRAM_SCLK: R28W.2, U4W.6
PSRAM_SIO0: R29W.2, U4W.5
PSRAM_SIO1: R30W.2, U4W.2
PSRAM_SIO2: R26W.2, R31W.2, U4W.3
PSRAM_SIO3: R25W.2, R32W.2, U4W.7
USB_B_N: L2W.2, P2W.20, TP22W.1
USB_B_P: L2W.1, P2W.22, TP23W.1
VSys: P2W.9, TP27W.1
\BT_RST: P2W.16, R2W.2, TP2W.1, TP21W.1
