Prototype-Fund-Hardware/MYND-Hardware/PCB_Schematic/KiCad/Jack_USB/Mynd_USB_JACK.kicad_pcb

## KiCad design PCB_Schematic/KiCad/Jack_USB/Mynd_USB_JACK.kicad_pcb (2025-05-21)

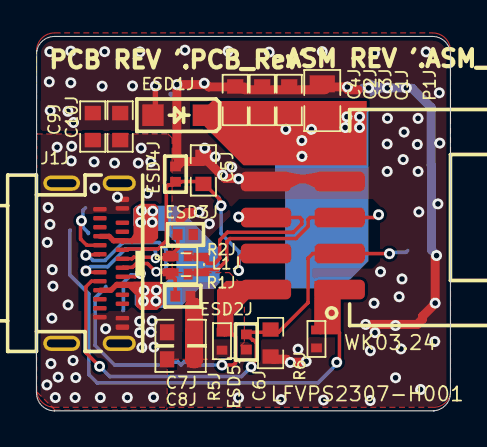
[picture p79: board Mynd_USB_JACK.kicad_pcb from above]

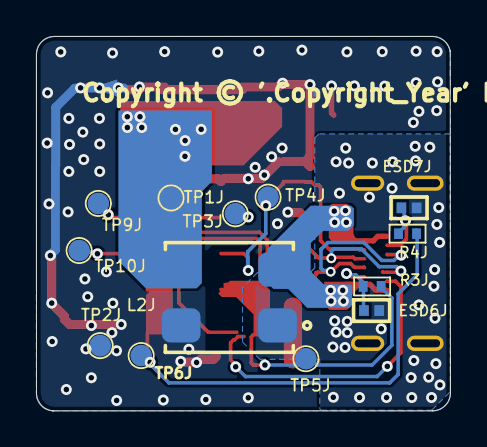
[picture p80: board Mynd_USB_JACK.kicad_pcb from below]

Board: 2 copper layers, 23.0 x 20.8 mm, 39 parts (14 on the bottom side), 14 nets.

Parts:
C1J: 2.2uF; C0805_145
C2J, C8J, C10J: 100nF; C0603X100
C3J, C4J: 10nF; C0603X100
C5J, C6J: 470pF; C0603X80
C7J, C9J: 1nF; C0603X100
ESD1J: SMF26AL; SOD-123FL
ESD2J, ESD3J, ESD4J, ESD5J, ESD6J, ESD7J: CESD0501CU; DFN2_100X60X50_65
J1J: NG-HC-0412; USB_TYPE_C_HC_0768
L1J: 90R; CET2012D
L2J: 700R; DU_IND_SMD_SCM7060
P1J: WB200AW-10; WB200AW_2x5P
R1J, R2J, R3J, R4J: 0R; R0402
R5J, R6J: NC; R0402
TP1J, TP2J, TP3J, TP4J, TP5J, TP6J, TP9J, TP10J: TP12; TP120
Teufel_ASM_Label1J: 3.2; Teufel_ASM_Rev
Teufel_Copyright1K: 2023; TEUFEL_COPYRIGHT
Teufel_PCB_Label1J: 3.2; Teufel_PCB_Rev
Teufel_PCB_Logo1K: T.3.0.0040-3.2; Teufel_NoLogo

Connections:
D2_1_N: ESD2J.2, J1J.A7, J1J.B7, L1J.2, R1J.1
D2_1_P: ESD3J.2, J1J.A6, J1J.B6, L1J.1, R2J.1
GND: C1J.2, C2J.2, C3J.2, C4J.2, C5J.2, C6J.2, C7J.2, C8J.2, C9J.2, C10J.2, ESD1J.A, ESD2J.1, ESD3J.1, ESD4J.2, ESD5J.2, L2J.4, P1J.7, P1J.8, R5J.1, R6J.1, TP2J.1
NetC7J_1: C7J.1, C8J.1, C9J.1, C10J.1, ESD6J.1, ESD7J.1, J1J.A1, J1J.A12, J1J.B1, J1J.B12, J1J.G1, J1J.G2, J1J.G3, J1J.G4, L2J.1
NetESD6J_2: ESD6J.2, J1J.A8, R3J.1
NetESD7J_2: ESD7J.2, J1J.B8, R4J.1
NetJ1J_A4: J1J.A4, J1J.A9, J1J.B4, J1J.B9, L2J.2
USB-CC1: C5J.1, ESD4J.1, J1J.A5, P1J.4, TP4J.1
USB-CC2: C6J.1, ESD5J.1, J1J.B5, P1J.3, TP10J.1
USB_J_N: L1J.3, P1J.5, R1J.2, TP9J.1
USB_J_P: L1J.4, P1J.6, R2J.2, TP3J.1
USB_SBU1: P1J.2, R3J.2, R5J.2, TP5J.1
USB_SBU2: P1J.1, R4J.2, R6J.2, TP6J.1
VBUS_C: C1J.1, C2J.1, C3J.1, C4J.1, ESD1J.K, L2J.3, P1J.9, P1J.10, TP1J.1
