Prototype-Fund-Hardware/MYND-Hardware/PCB_Schematic/KiCad/Conn_Bat/Mynd_Batt.kicad_pcb

## KiCad design PCB_Schematic/KiCad/Conn_Bat/Mynd_Batt.kicad_pcb (2025-05-21)

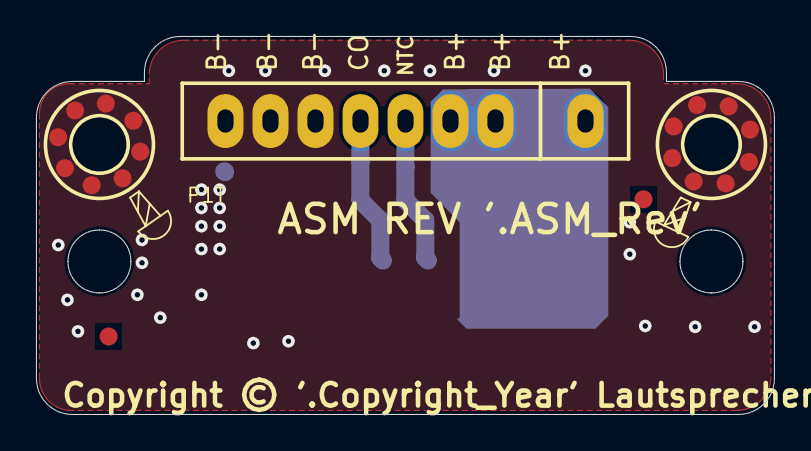
[picture p81: board Mynd_Batt.kicad_pcb from above]

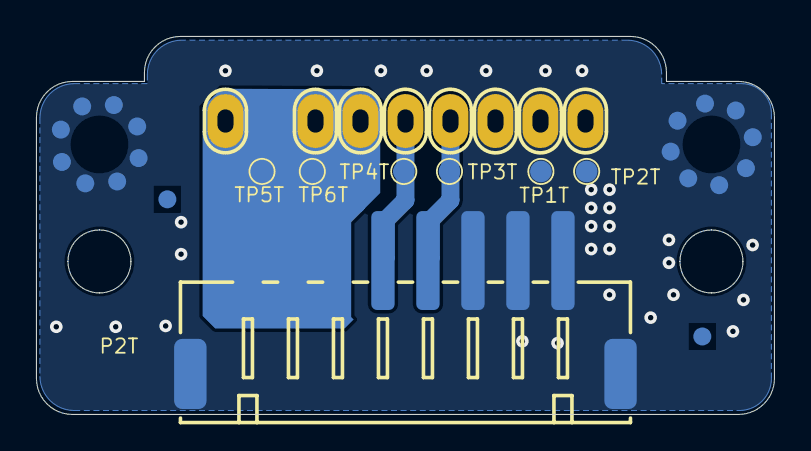
[picture p82: board Mynd_Batt.kicad_pcb from below]

Board: 2 copper layers, 41.0 x 21.0 mm, 15 parts (7 on the bottom side), 4 nets.

Parts:
MH1T, MH2T: SCREW_HOLE; SCREW_D30
MK1T, MK2T: MARK
P1T: 8P PITCH=2.5mm; TSB1_05282
P2T: WT250MW-084R-0W; CON_250_SMD_H_8P
TP1T, TP2T, TP3T, TP4T, TP5T, TP6T: TP12; TP120
Teufel_ASM_Label1T: 3.1; Teufel_ASM_Rev
Teufel_Copyright1T: 2023; TEUFEL_COPYRIGHT
Teufel_PCB_Logo1T: Teufel_NoLogo

Connections:
Bat+: P1T.1, P1T.2, P1T.3, P2T.6, P2T.7, P2T.8, TP5T.1, TP6T.1
Bat-: MH1T.1, MH2T.1, P1T.6, P1T.7, P1T.8, P2T.0, P2T.1, P2T.2, P2T.3, TP1T.1, TP2T.1
C_Open: P1T.5, P2T.4, TP3T.1
NTC: P1T.4, P2T.5, TP4T.1
