Prototype-Fund-Hardware/MYND-Hardware/(notices)

Notices in the files:
parts and their libraries:
Teufel Copyright PCB Label
Copyright © '.Copyright_Year' Lautsprecher Teufel GmbH
